intel-aero/Documents/doc_photos/pixhawk_aero_pinout.png

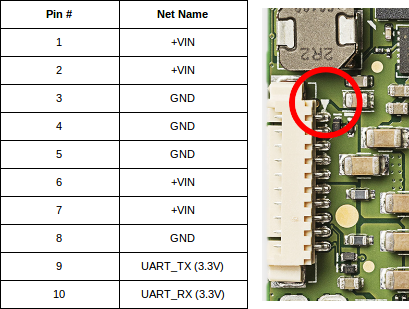
doc_photos/pixhawk_aero_pinout.png
