intel-aero/Documents/doc_photos/install_01_md5sum_linux.png

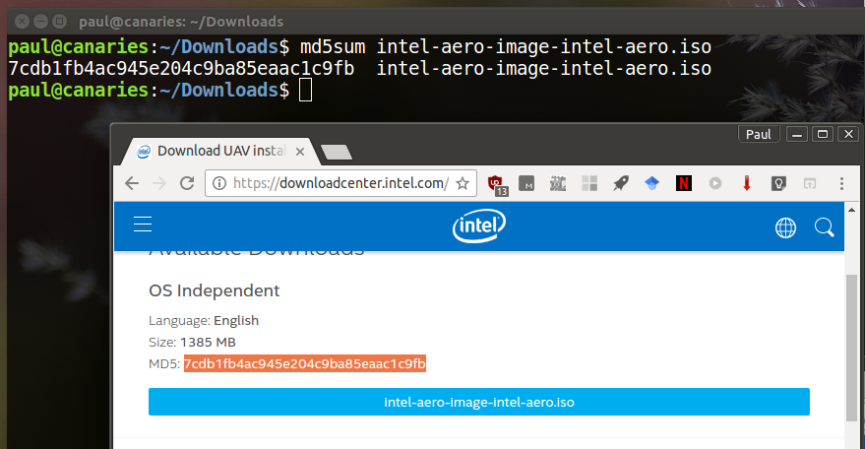
doc_photos/install_01_md5sum_linux.png
