intel-aero/Documents/README.md

# DISCONTINUATION OF PROJECT #
This project will no longer be maintained by Intel.
Intel has ceased development and contributions including, but not limited to, maintenance, bug fixes, new releases, or updates, to this project.
Intel no longer accepts patches to this project.
# Documents
Repo to upload Reference Documents and Mechanical CADs
