intel-aero/Documents/course/Readme.md

# Autonomous Drone Engineer Course

Do you know how power lines are checked? They send a customized helicopter with a highly trained crew to take photos. It’s slow, expensive and dangerous. The next step is of course to use a remotely controlled drone to take the pictures. It’s still slow and not scalable to the full size of the power line network.

That’s why we need autonomous drones, able to fly but also avoid collisions and analyze the situation as they go. Autonomous Drone Engineers will need to master a wide range of skills, from computer vision basics, embedded development and drone hardware design.

## Requirements
Linux programming in Python or C/C++. Basic Linux sysadmin.

[Intel Aero Ready-To-Fly Drone](http://intel.com/aero)

## Competences

After this training, the student will be able to:
•	analyze drone usage models, business models and market - relevant for all persons involved in drone projects
•	understand autonomous drone hardware and software architecture - relevant for drone developers and project managers
•	basic safe flight, drone maintenance skills, work with regulation - relevant for drone operator and drone developers
•	develop autonomous drones software for simple use cases - ex: following and adapting a mission outdoor
•	develop autonomous drones software for advanced use cases - ex: flying indoor or flights with strong flight-payload interactions

## Links:

* In parallel to the slides/videos, you should use the [Intel Aero's main wiki page](https://github.com/intel-aero/meta-intel-aero/wiki). Tip: It's easier to copy/paste code from the wiki than the slides.

* [Youtube Playlist](https://www.youtube.com/playlist?list=PLTQSXsG86pGfyZm5ac6-ZtQsEniUJIE9o)

* [Slides corresponding to the videos, in PPTX format](pptx)

* [Slides corresponding to the videos, in PDF format](pdf)

## Table of contents, with modules released and planned:
__A. Introduction__
* Intel Aero in 5mn.
* Autonomous Drone Usage Models.
* _Drones in society (soon)_

__B. Architecture__
* Introduction.
* Hardware architecture.
* 3D and visual sensors.
* Software Architecture.

__C.Lab setup__
* Flashing and lab setup.

__D. Drone software development__
* Hello world flight controller.
* Hello world networked drone.
* Docker containers.
* _ROS (very soon)_
* _Access cameras and stream (very soon)_

__E. Advanced drone software development__
* _Collision avoidance (soon)_
* _VISP (soon)_
* _SLAM (soon)_
* _Movidius Computer Vision (soon)_
* _Big Data in Real Time (soon)_
* _Gazebo simulator (soon)_

__F. Server side software development__
* _Cloud Sync (soon)_
* _SAP integration (soon)_
* _Mapping and GeoData (soon)_
* _3D reconstruction (soon)_
* _Big Data (soon)_

__G.	Productizing__
* _VPNs (very soon)_
* _LTE Modem (soon)_
* _3D printing accessories (very soon)_

__H.	Entrepreneurship__
* _Ecosystem (soon)_
* _Ideation (soon)_
* _Promotion (soon)_
