intel-aero/Documents/doc_photos/aero_gazebo.png

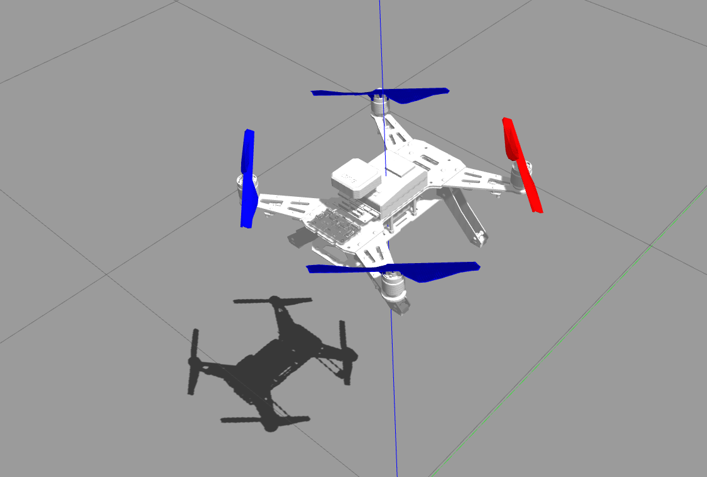
doc_photos/aero_gazebo.png
