intel-aero/Documents/doc_photos/cables_jack.jpg

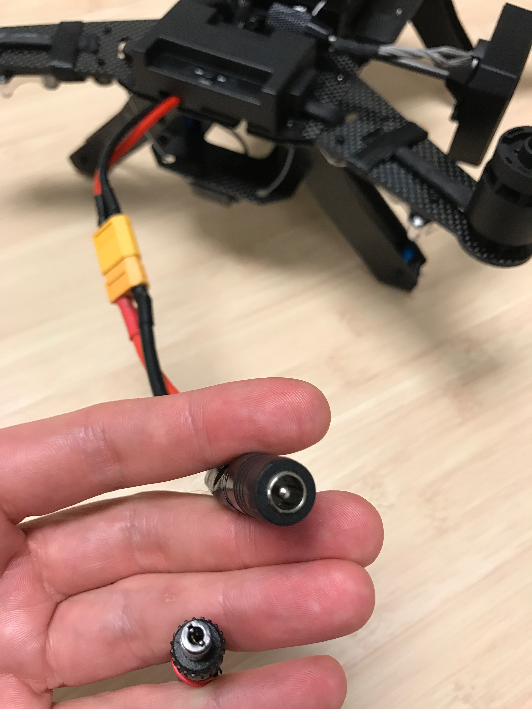
doc_photos/cables_jack.jpg
