intel-aero/Documents/doc_photos/cables_microHDMI.jpg

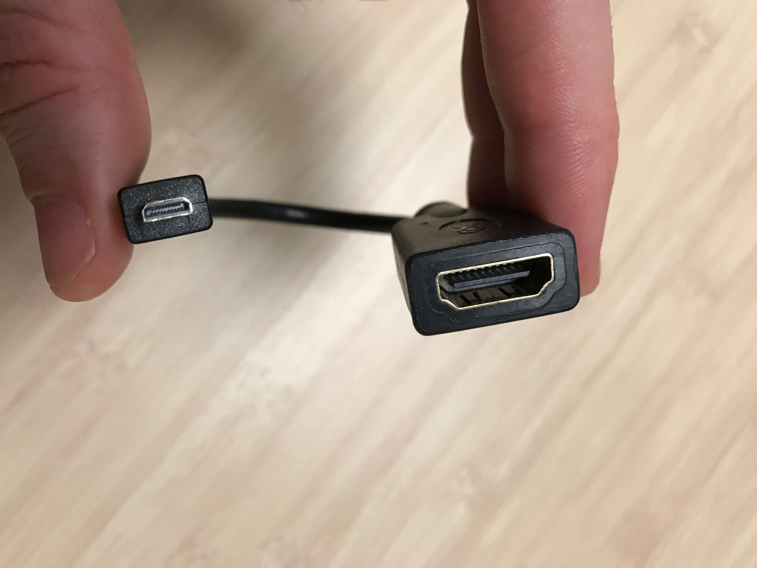
doc_photos/cables_microHDMI.jpg
