intel-aero/Documents/doc_photos/cables_OTG-USB2.jpg

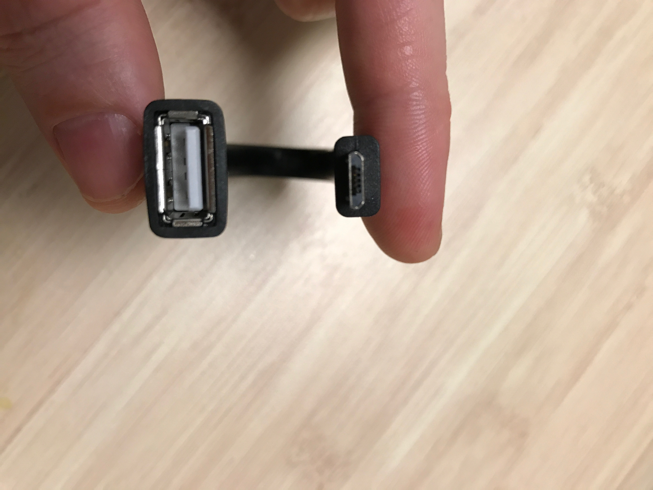
doc_photos/cables_OTG-USB2.jpg
