intel-aero/Documents/doc_photos/cables_usb-hdmi-connected.jpg

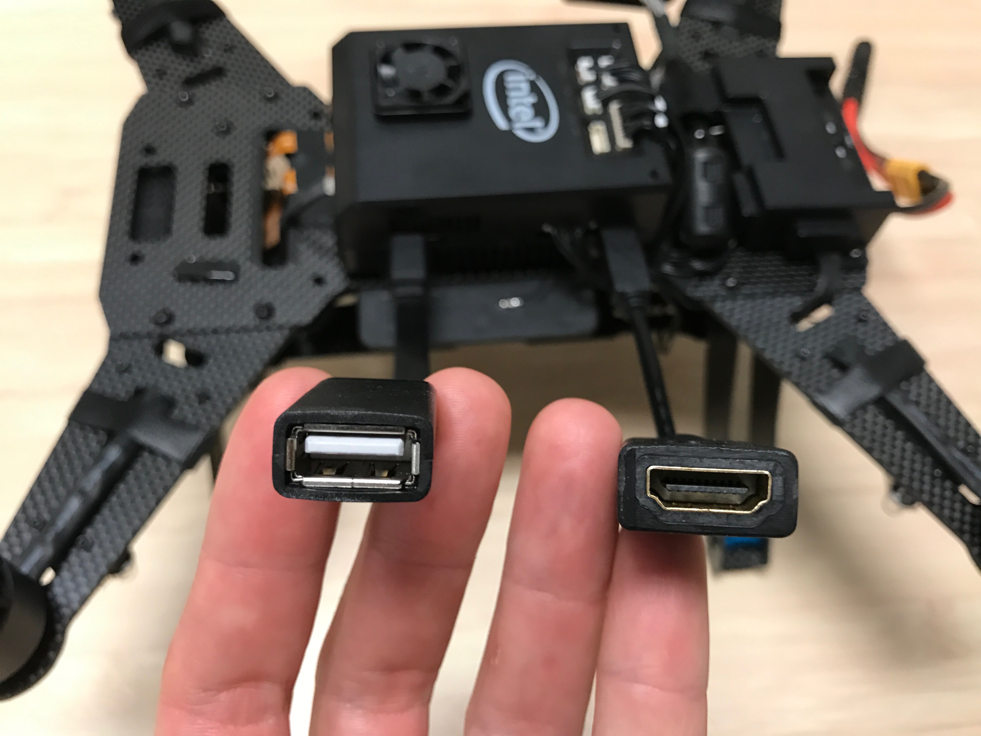
doc_photos/cables_usb-hdmi-connected.jpg
