intel-aero/Documents/doc_photos/cables_XT60.jpg

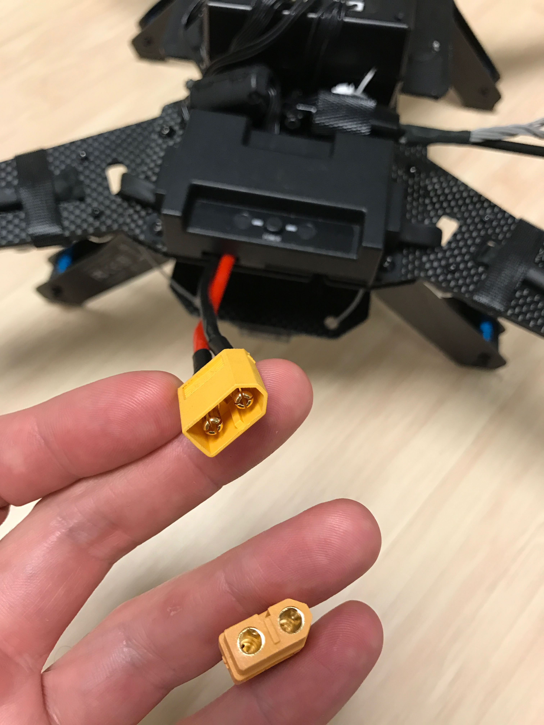
doc_photos/cables_XT60.jpg
