intel-aero/Documents/doc_photos/camera_bottom.png

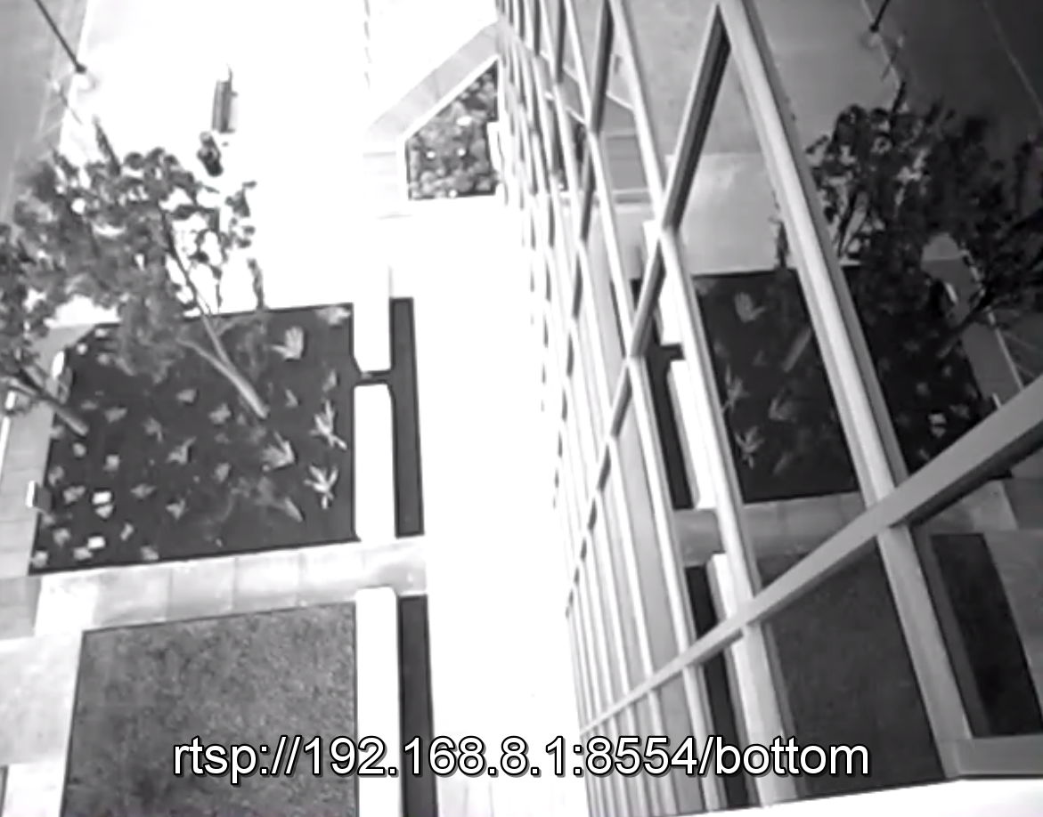
doc_photos/camera_bottom.png
