intel-aero/Documents/doc_photos/ecosystem-skysense.jpg

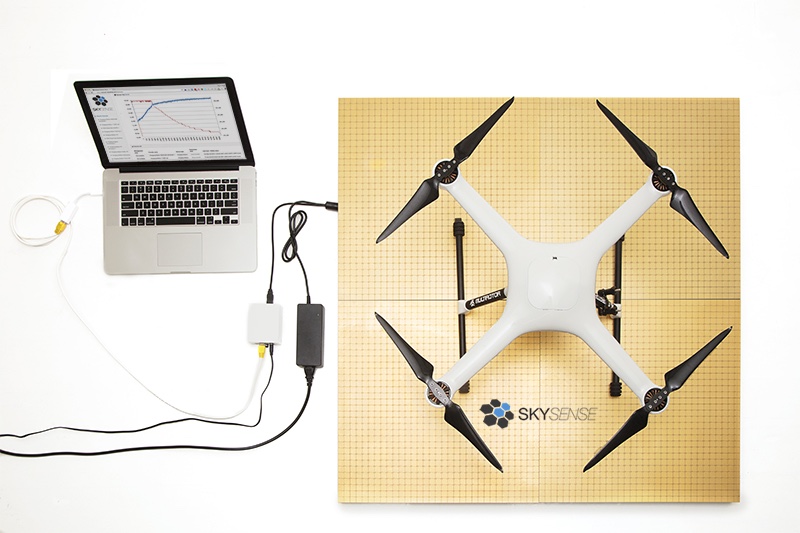
doc_photos/ecosystem-skysense.jpg
