intel-aero/Documents/doc_photos/fcm.png

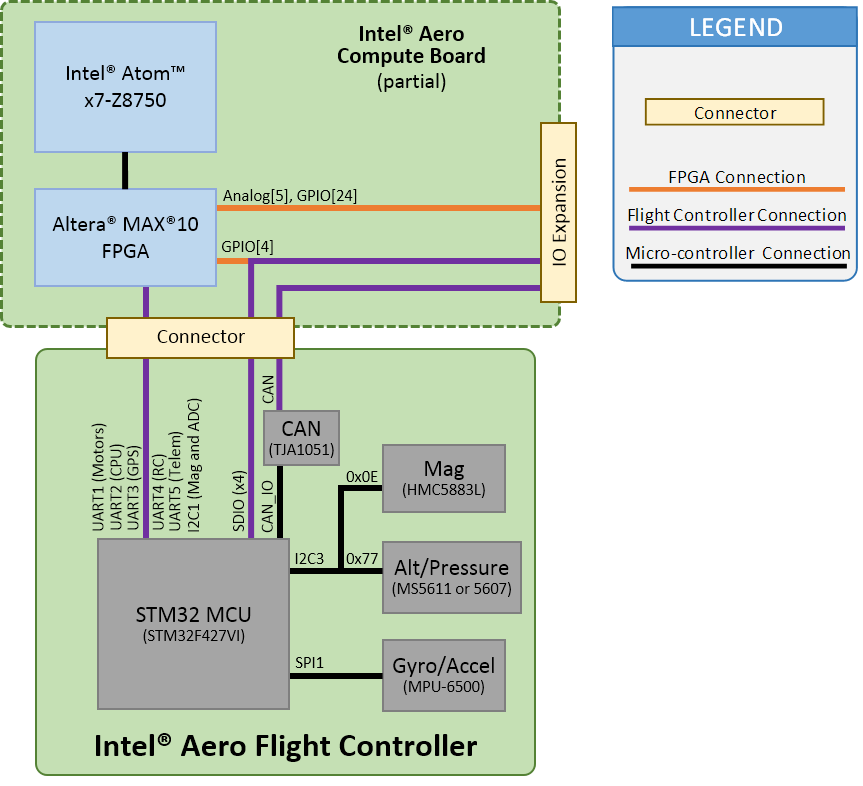
doc_photos/fcm.png
