intel-aero/Documents/doc_photos/guvcview.png

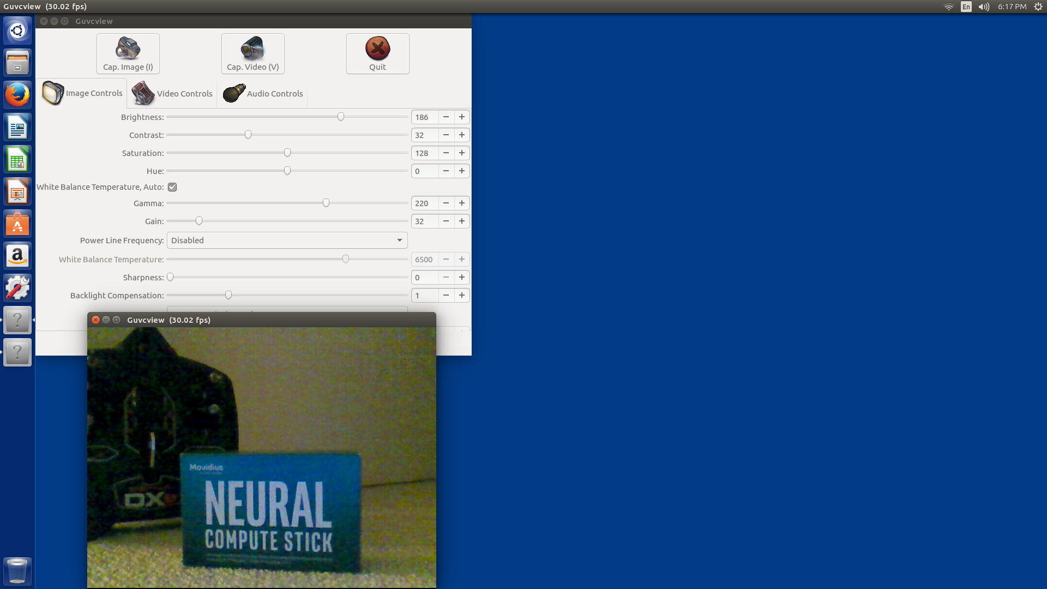
doc_photos/guvcview.png
