intel-aero/Documents/doc_photos/lte_enclosure.png

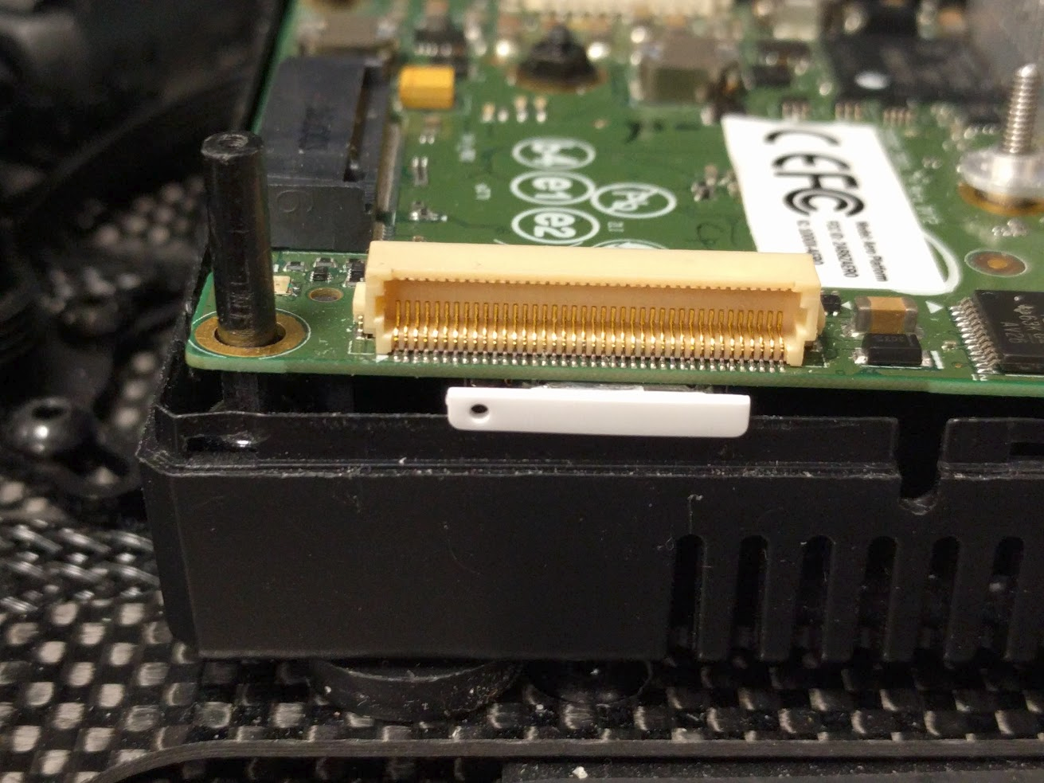
doc_photos/lte_enclosure.png
