intel-aero/Documents/doc_photos/lte_enclosure_modified.png

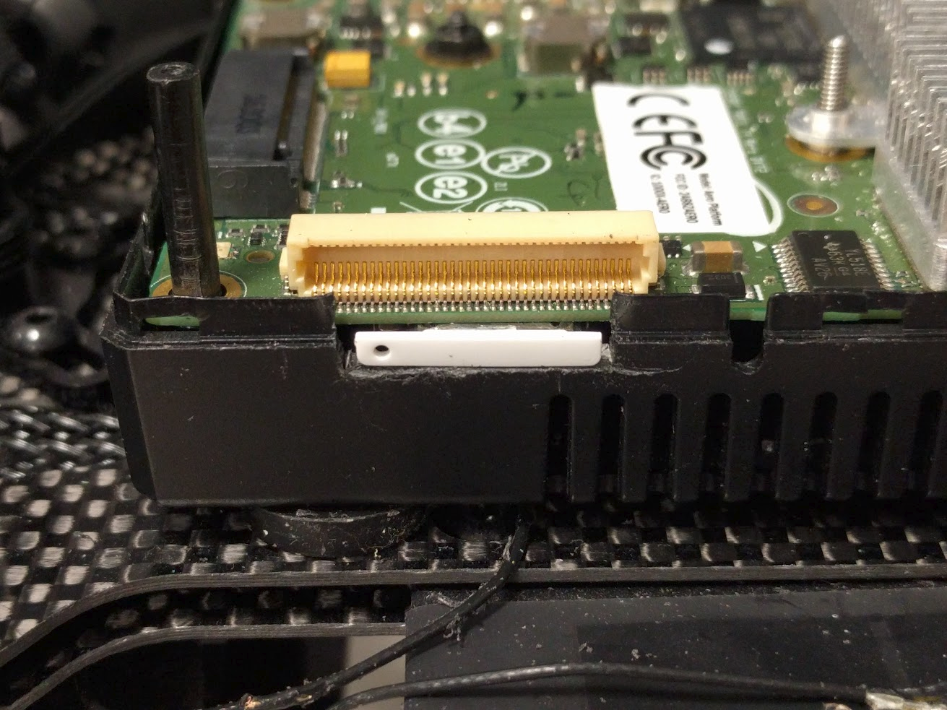
doc_photos/lte_enclosure_modified.png
