intel-aero/Documents/doc_photos/lte_modem_antenna.png

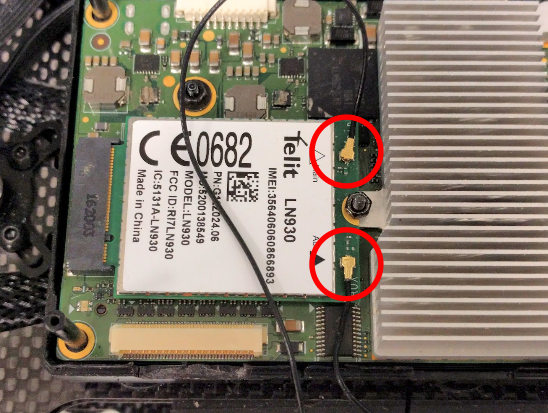
doc_photos/lte_modem_antenna.png
