intel-aero/Documents/doc_photos/lte_modem_fit.png

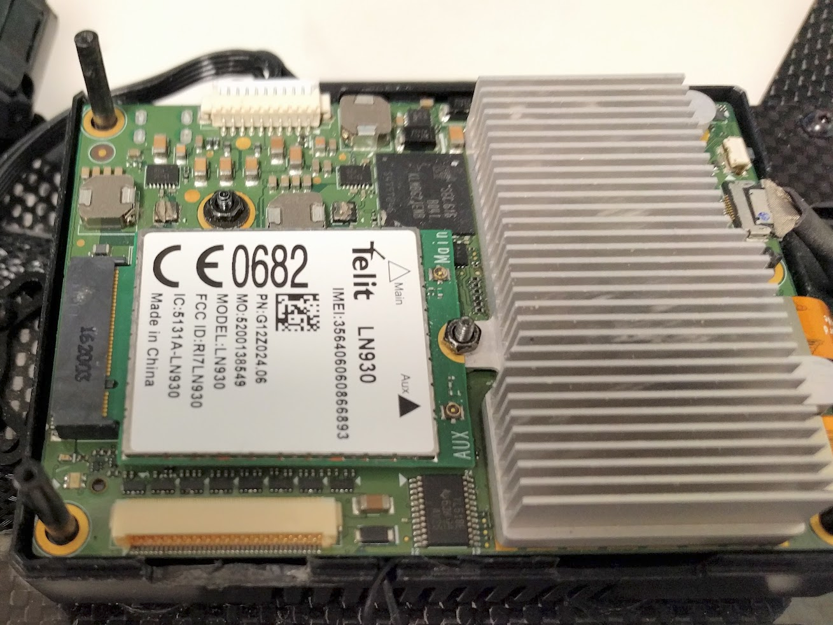
doc_photos/lte_modem_fit.png
