intel-aero/Documents/doc_photos/lte_modem_tilt.png

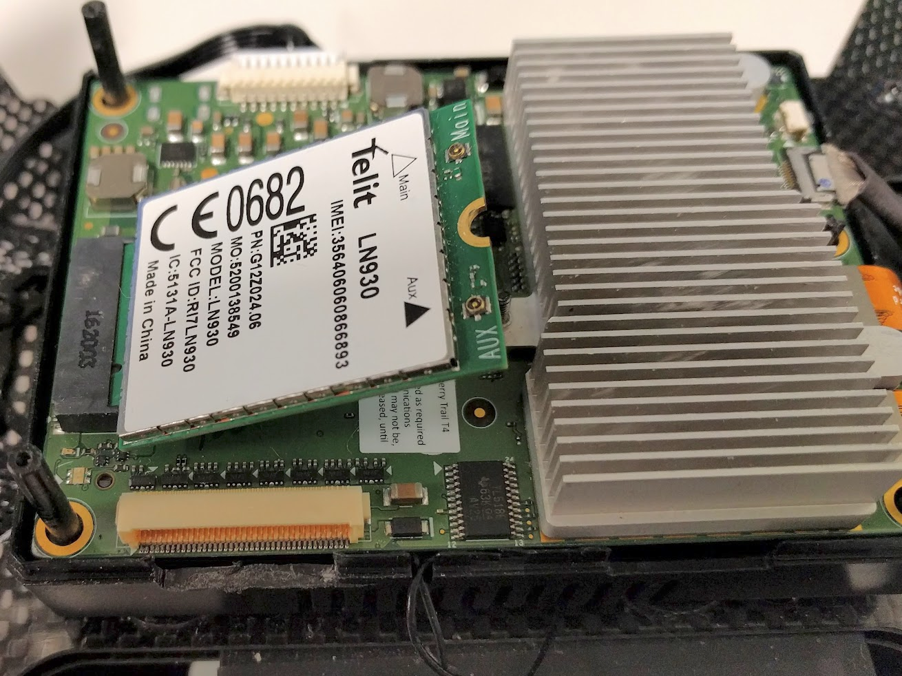
doc_photos/lte_modem_tilt.png
