intel-aero/Documents/doc_photos/lte_wifi_antenna.png

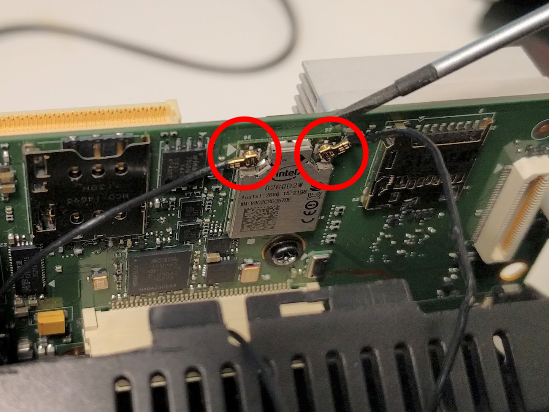
doc_photos/lte_wifi_antenna.png
