intel-aero/Documents/doc_photos/movidius_pekinese.png

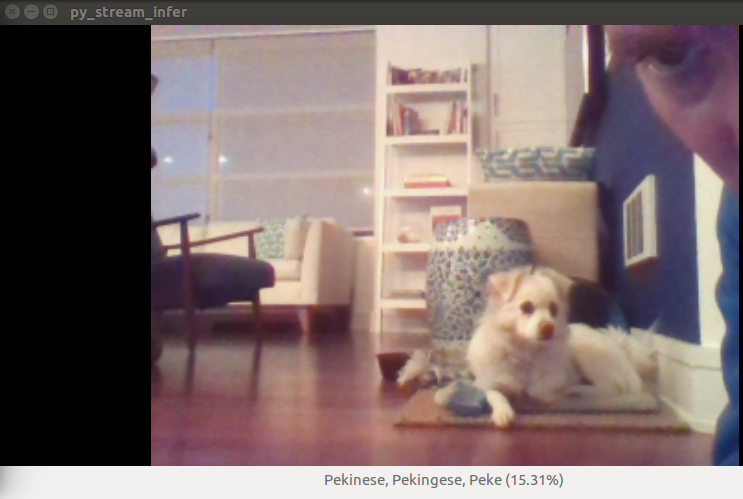
doc_photos/movidius_pekinese.png
