intel-aero/Documents/doc_photos/pixhawk_aero.png

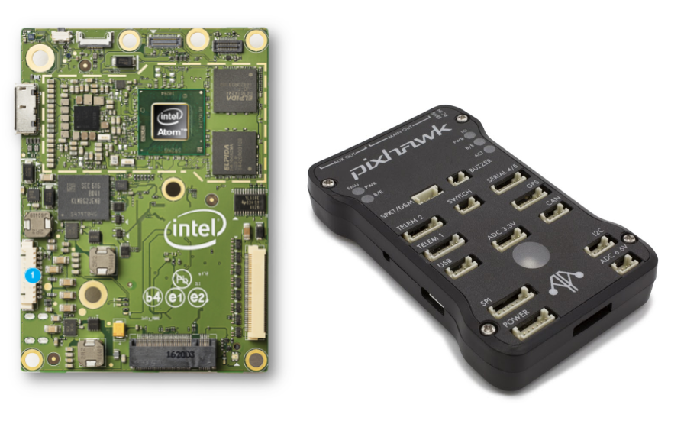
doc_photos/pixhawk_aero.png
