intel-aero/Documents/doc_photos/pixhawk_aero_ports.png

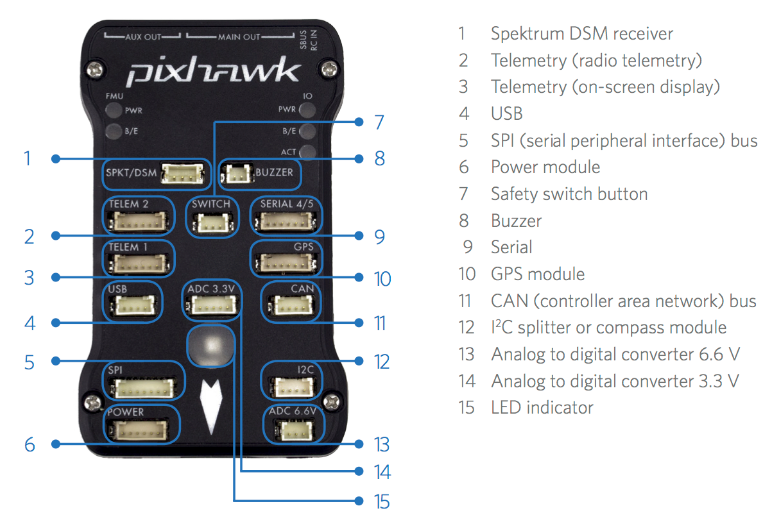
doc_photos/pixhawk_aero_ports.png
