intel-aero/Documents/doc_photos/pixhawk_aero_power_cable.jpg

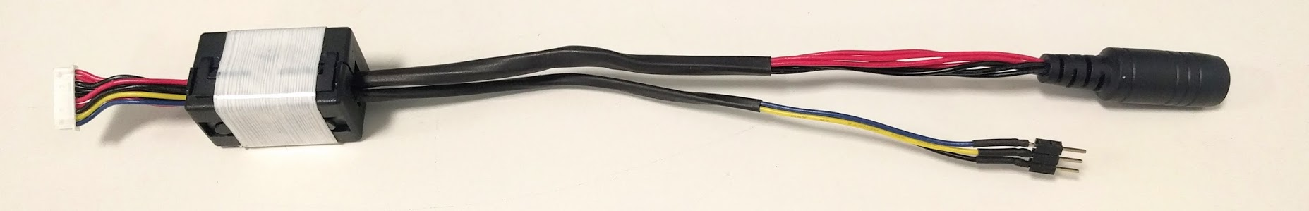
doc_photos/pixhawk_aero_power_cable.jpg
