intel-aero/Documents/doc_photos/pixhawk_aero_uart_cable.png

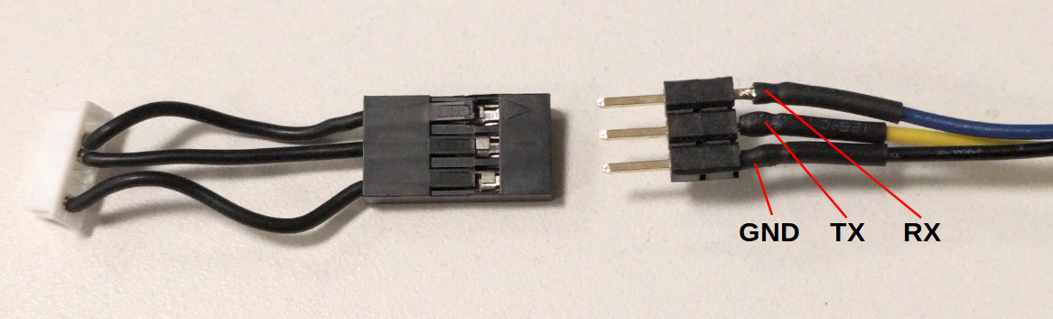
doc_photos/pixhawk_aero_uart_cable.png
