intel-aero/Documents/doc_photos/pixhawk_pinout.png

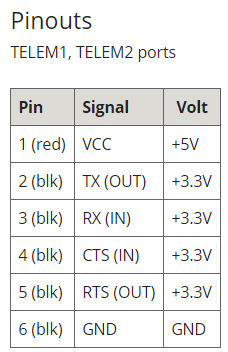
doc_photos/pixhawk_pinout.png
