intel-aero/Documents/doc_photos/playlist.png

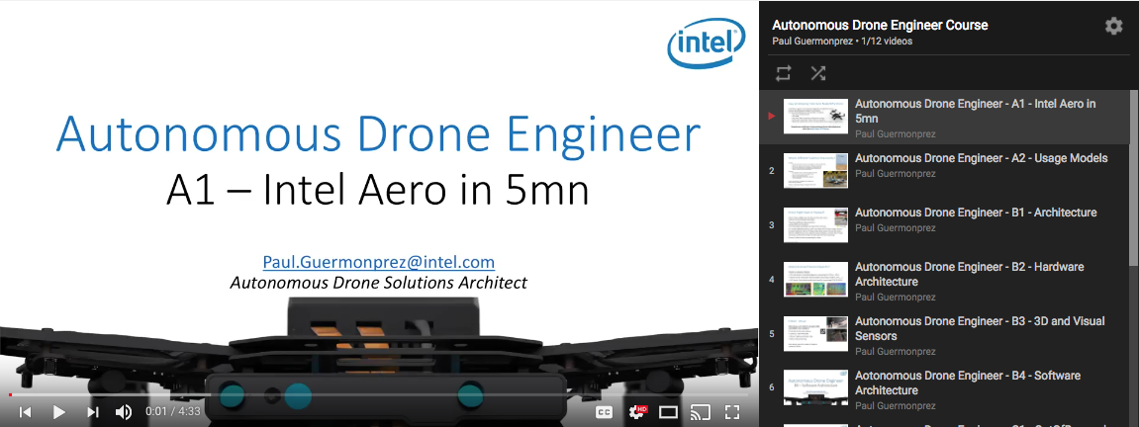
doc_photos/playlist.png
