intel-aero/Documents/doc_photos/python_eric.png

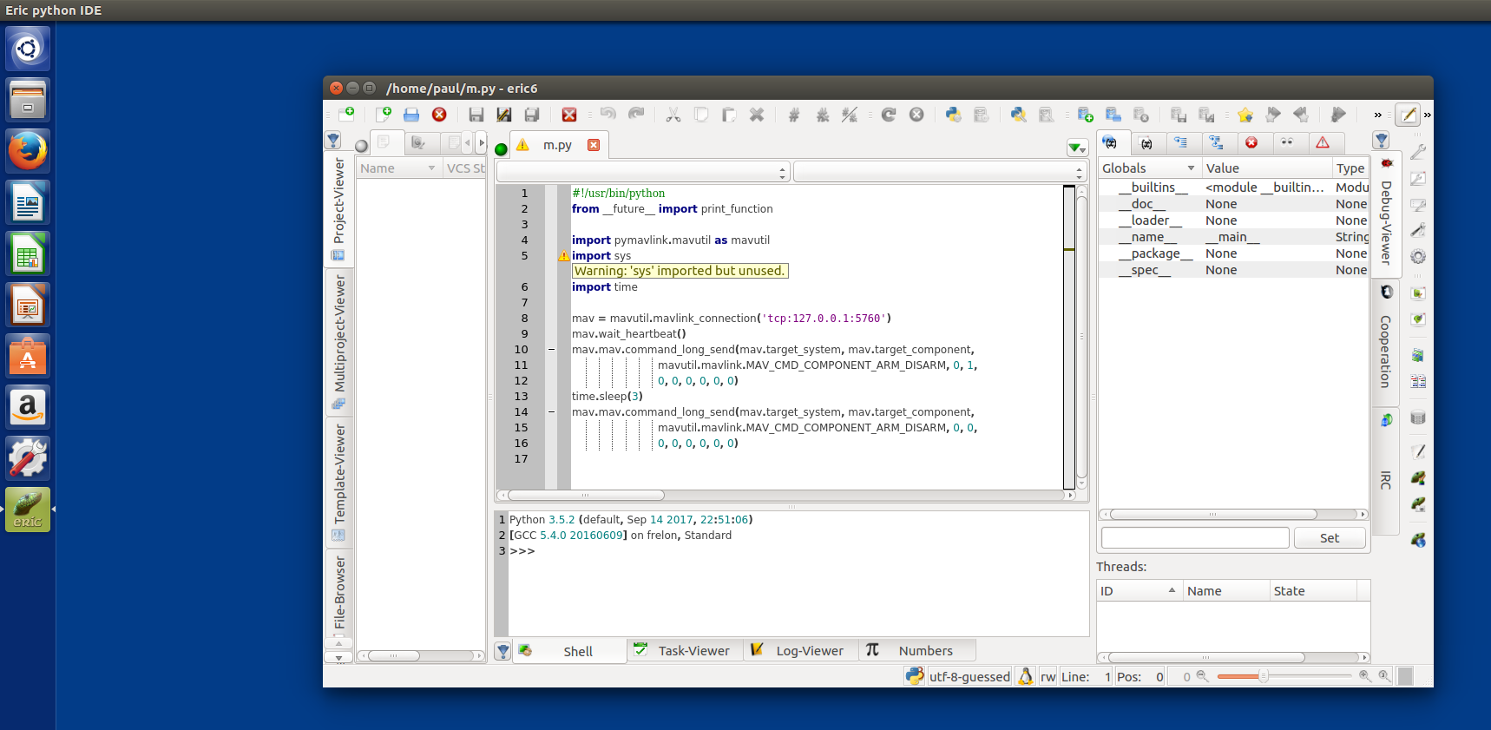
doc_photos/python_eric.png
