intel-aero/Documents/doc_photos/python_idle.png

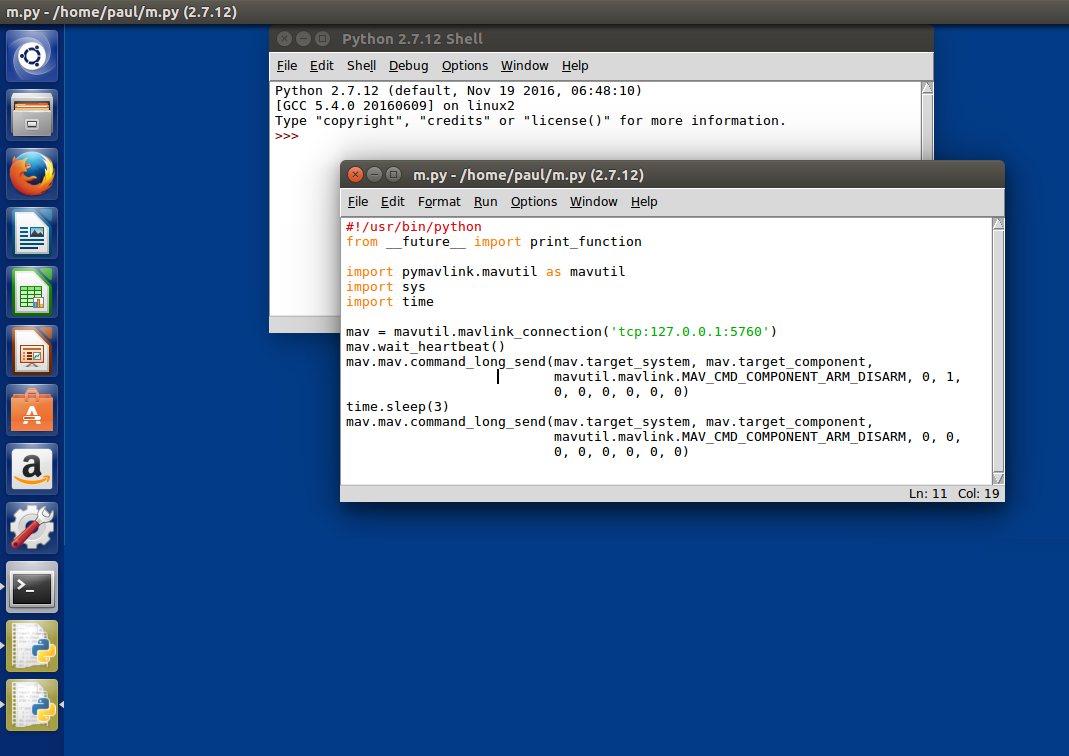
doc_photos/python_idle.png
