intel-aero/Documents/doc_photos/python_vim.png

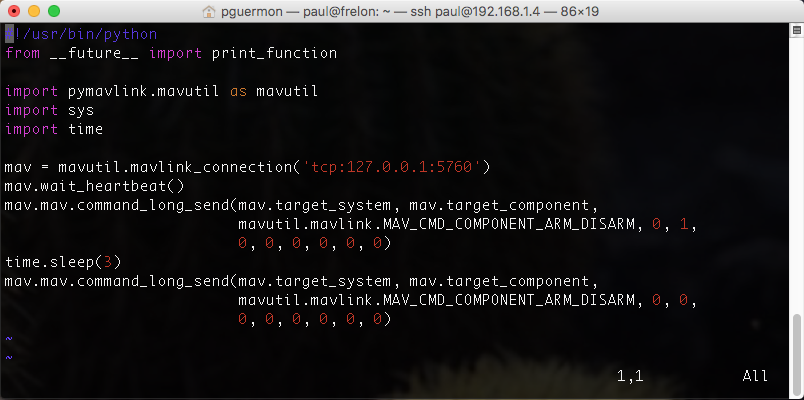
doc_photos/python_vim.png
