intel-aero/Documents/doc_photos/qgc_connected.png

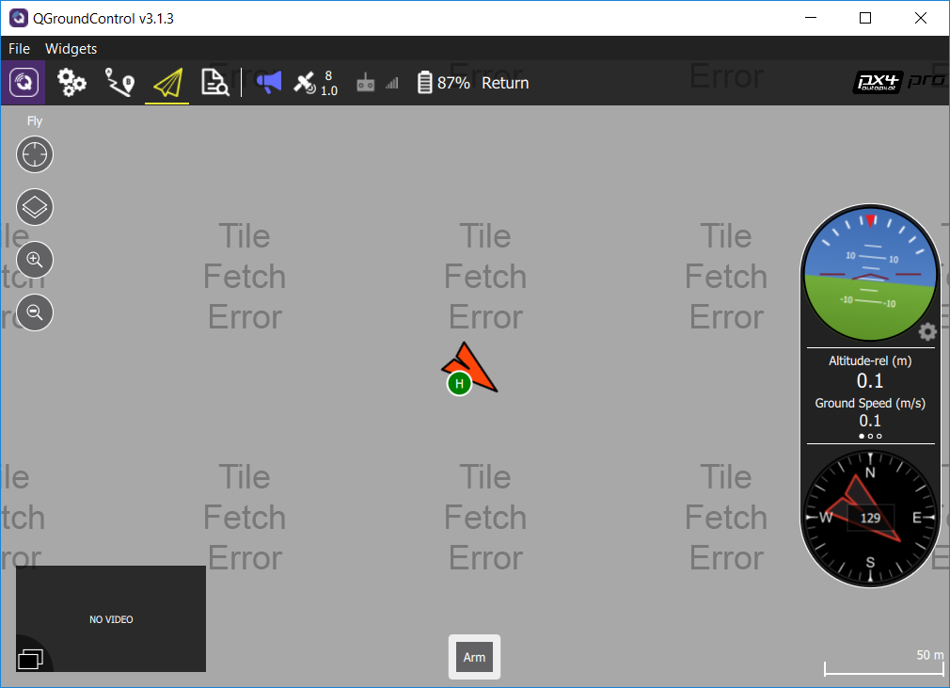
doc_photos/qgc_connected.png
