intel-aero/Documents/doc_photos/qgc_notconnected.png

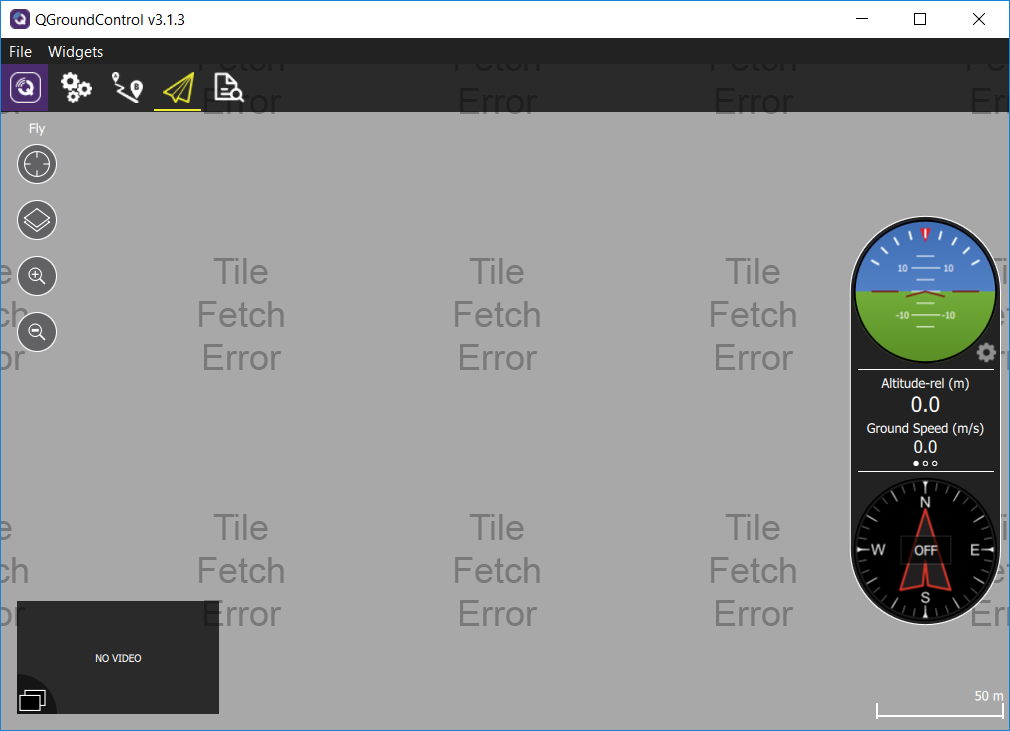
doc_photos/qgc_notconnected.png
