intel-aero/Documents/doc_photos/qgc_rtsp.png

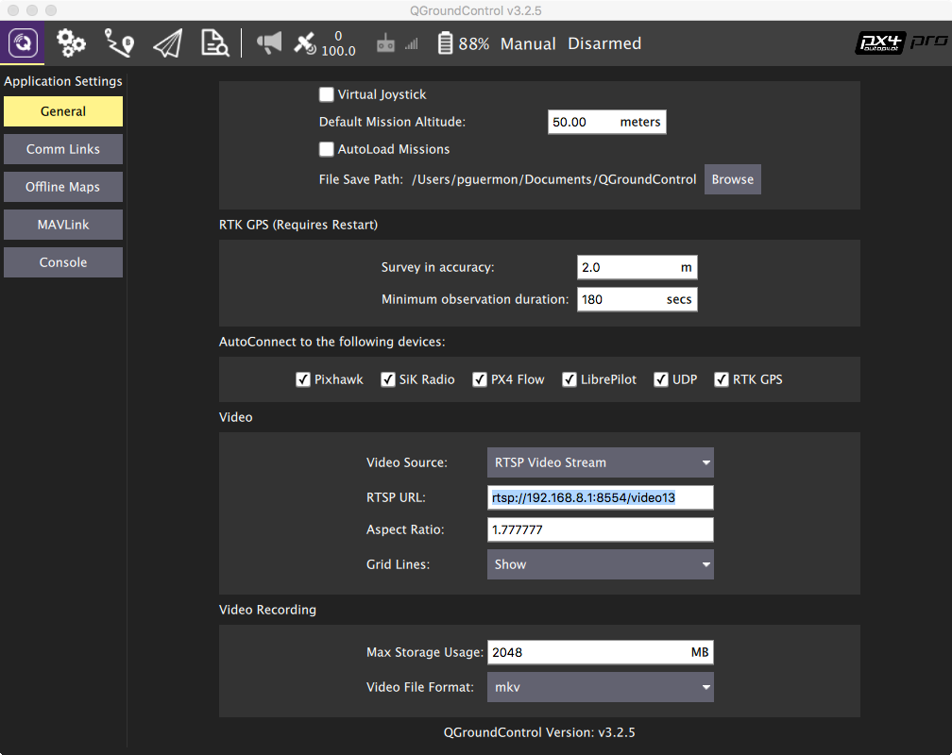
doc_photos/qgc_rtsp.png
