intel-aero/Documents/doc_photos/qgc_rtsp_video.png

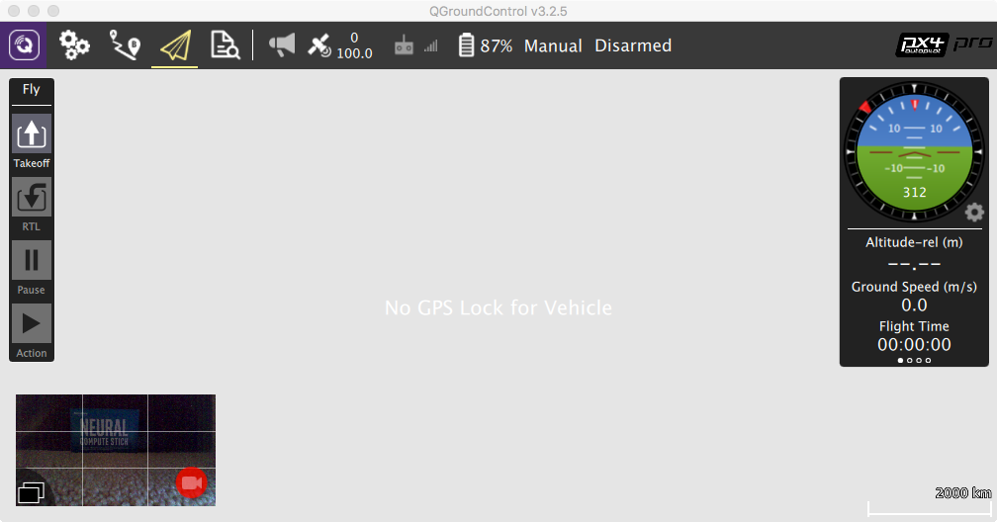
doc_photos/qgc_rtsp_video.png
