intel-aero/Documents/doc_photos/rgb-led-rtf.png

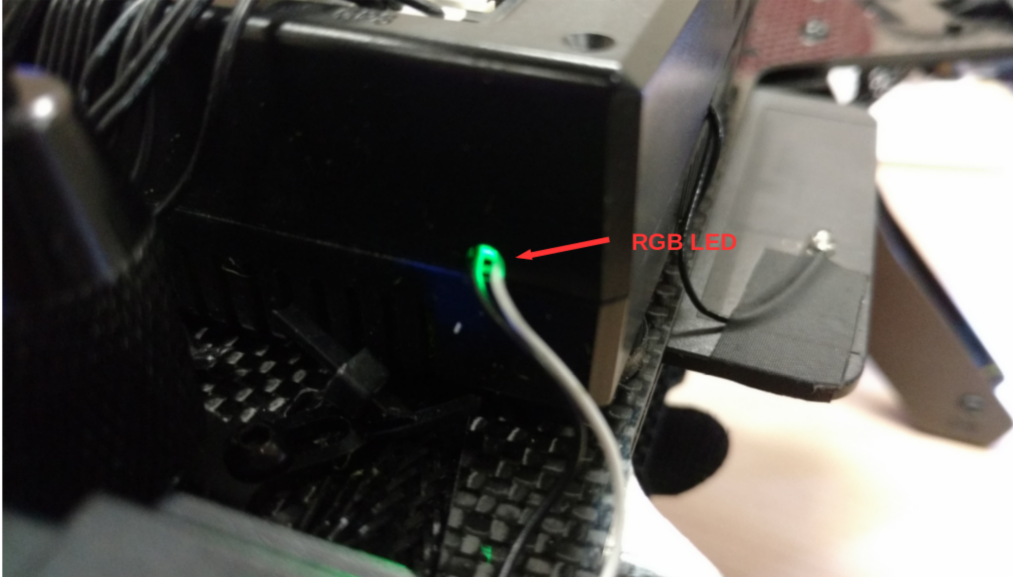
doc_photos/rgb-led-rtf.png
