intel-aero/Documents/doc_photos/ros_pointcloud.png

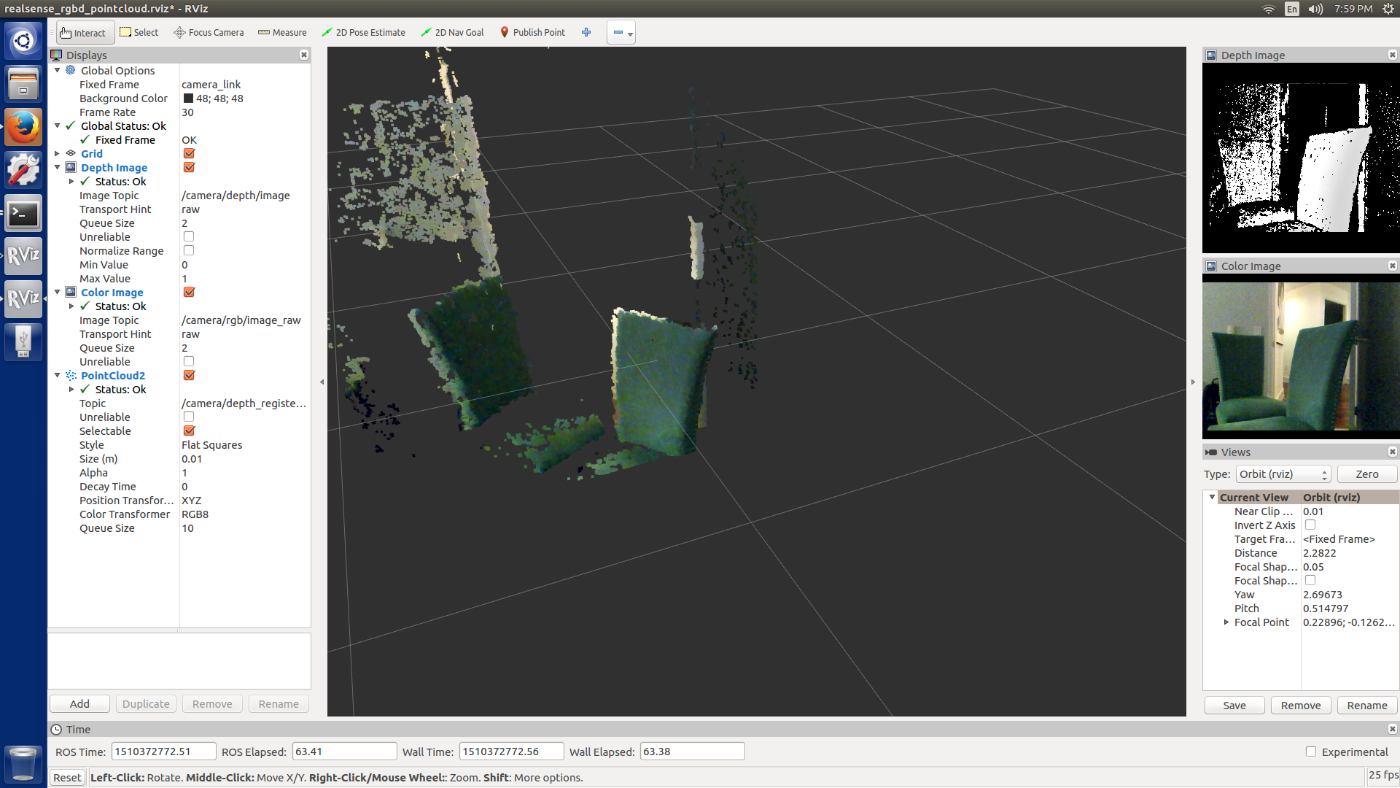
doc_photos/ros_pointcloud.png
