intel-aero/Documents/doc_photos/ros_slam.png

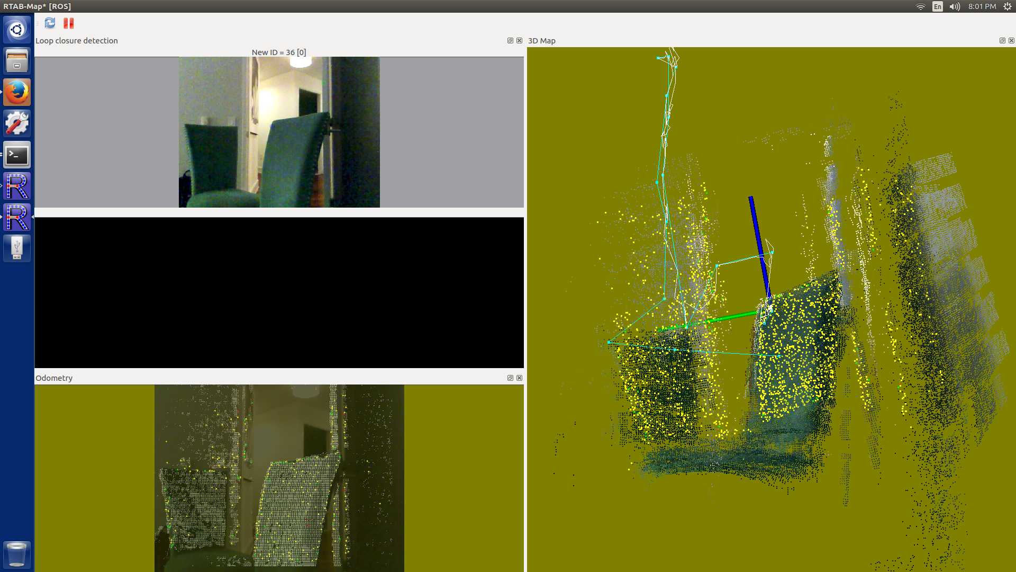
doc_photos/ros_slam.png
