intel-aero/Documents/doc_photos/ros_terms.png

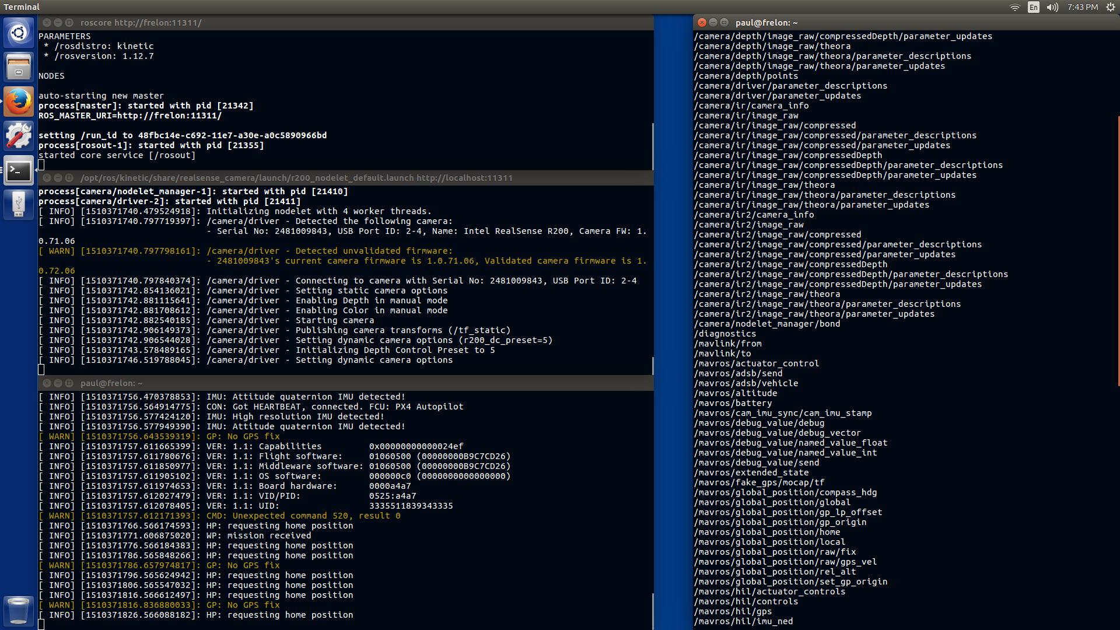
doc_photos/ros_terms.png
