intel-aero/Documents/doc_photos/rs_color_intel.png

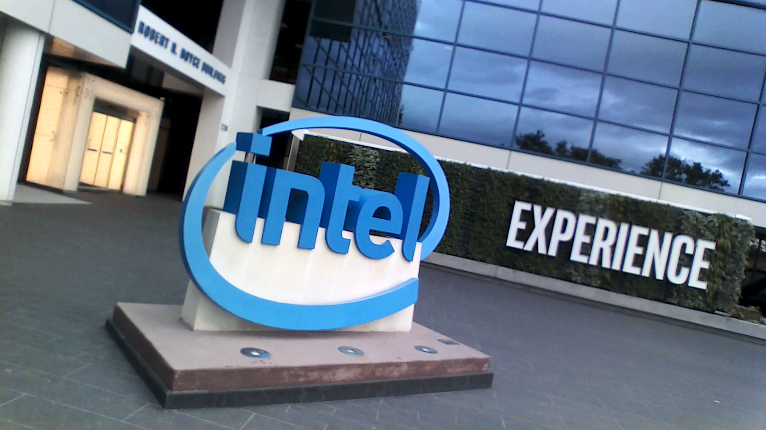
doc_photos/rs_color_intel.png
