intel-aero/Documents/doc_photos/rs_cpp-capture_chairs.png

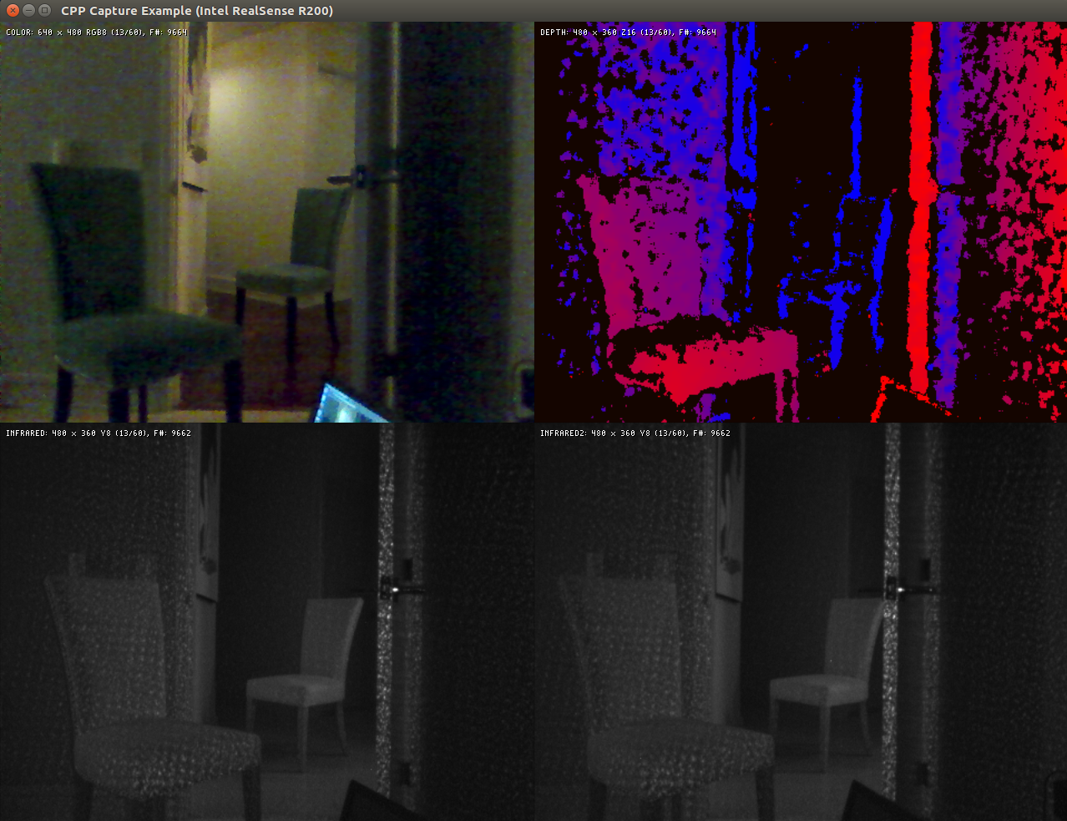
doc_photos/rs_cpp-capture_chairs.png
