intel-aero/Documents/doc_photos/rs_texture_dog.png

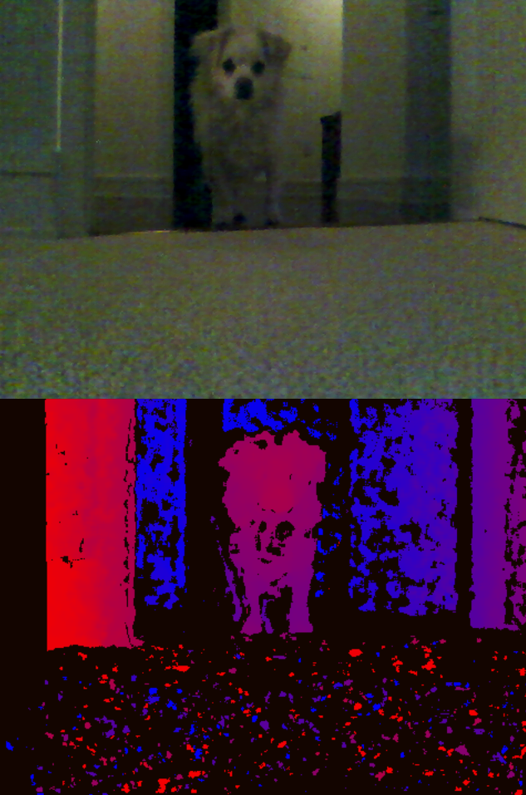
doc_photos/rs_texture_dog.png
