intel-aero/Documents/doc_photos/rs_works_in_the_dark.png

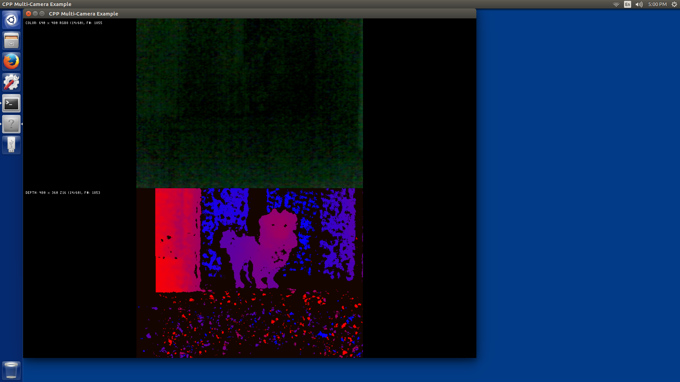
doc_photos/rs_works_in_the_dark.png
