intel-aero/Documents/doc_photos/sales_kit_1.jpg

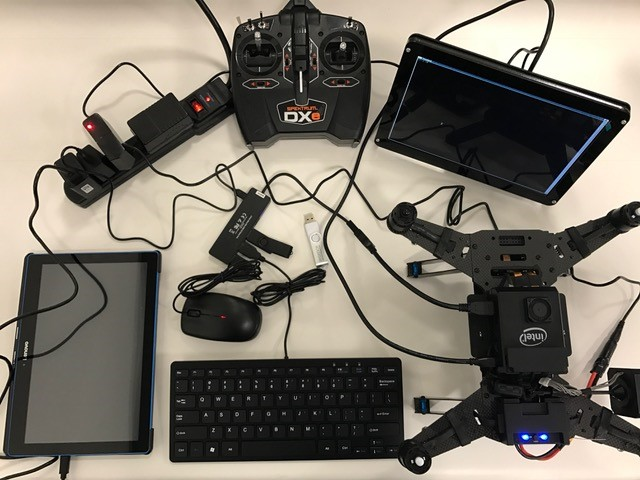
doc_photos/sales_kit_1.jpg
