intel-aero/Documents/doc_photos/sales_kit_2.jpg

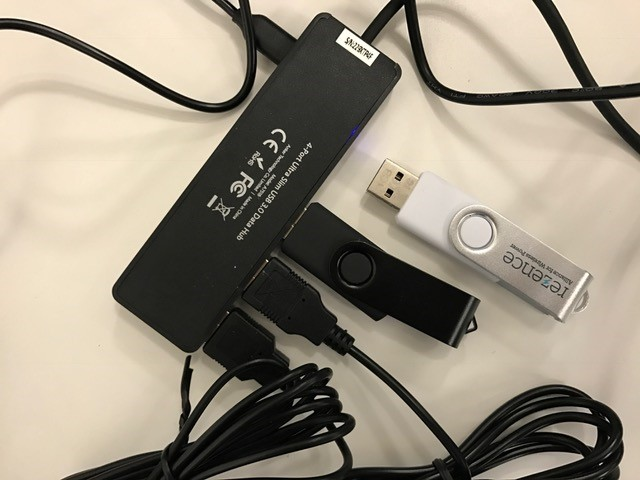
doc_photos/sales_kit_2.jpg
