intel-aero/Documents/doc_photos/sales_kit_3.jpg

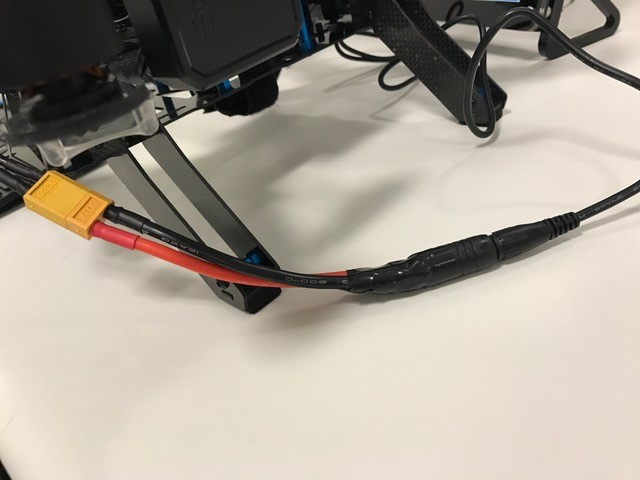
doc_photos/sales_kit_3.jpg
