intel-aero/Documents/doc_photos/sales_kit_4.jpg

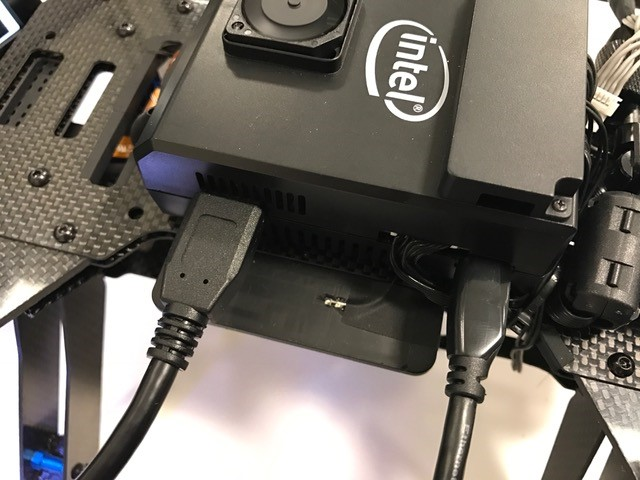
doc_photos/sales_kit_4.jpg
