intel-aero/Documents/doc_photos/unboxing_Intel_Aero_Compute_Board.jpg

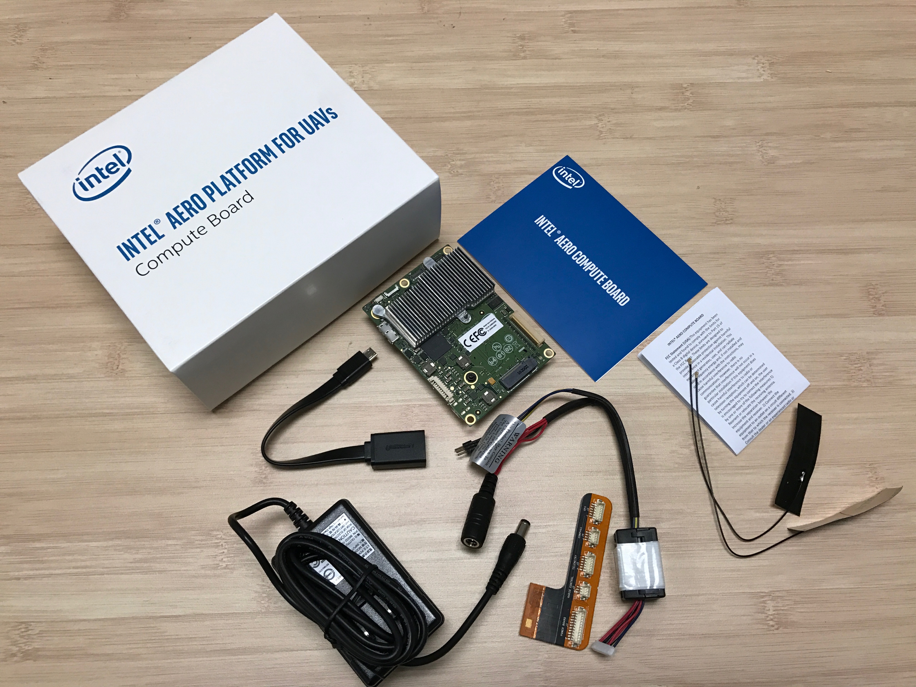
doc_photos/unboxing_Intel_Aero_Compute_Board.jpg
