intel-aero/Documents/doc_photos/unboxing_Intel_Aero_Computer_Vision_kit.jpg

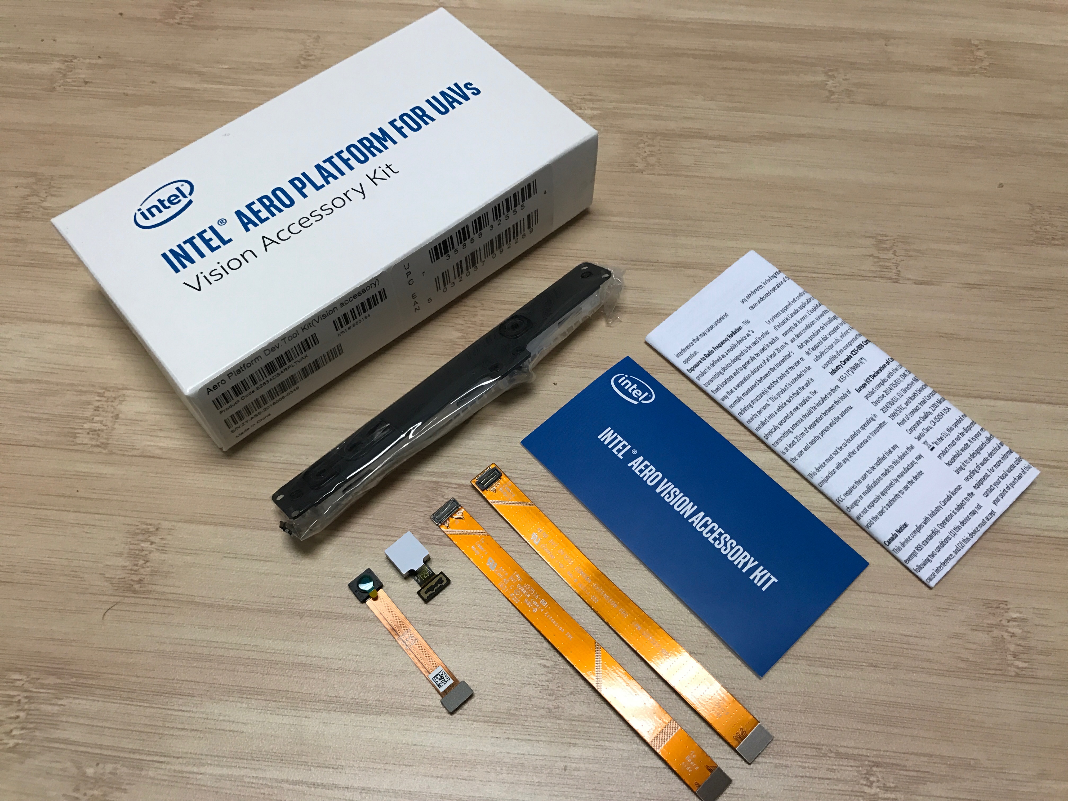
doc_photos/unboxing_Intel_Aero_Computer_Vision_kit.jpg
