intel-aero/Documents/doc_photos/unboxing_Intel_Aero_Enclosure_kit.jpg

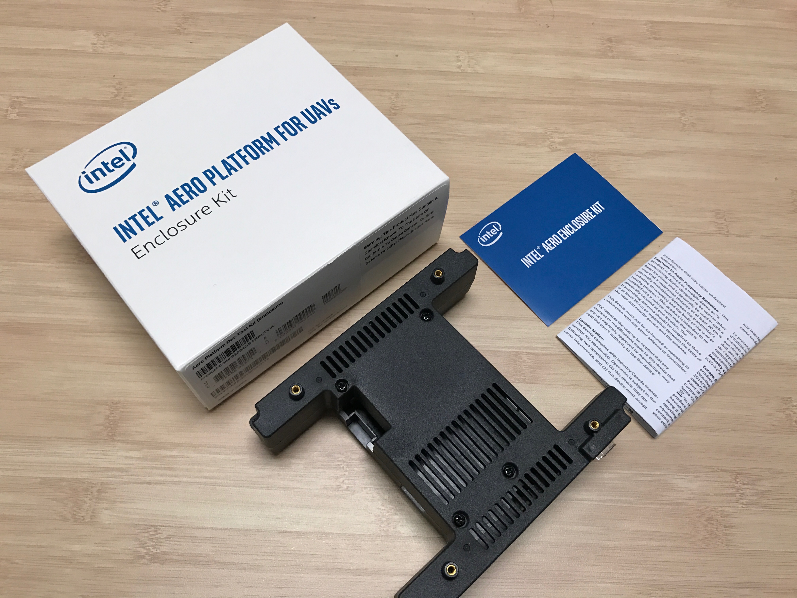
doc_photos/unboxing_Intel_Aero_Enclosure_kit.jpg
