intel-aero/Documents/doc_photos/unboxing_Intel_Aero_RTK_kit.jpg

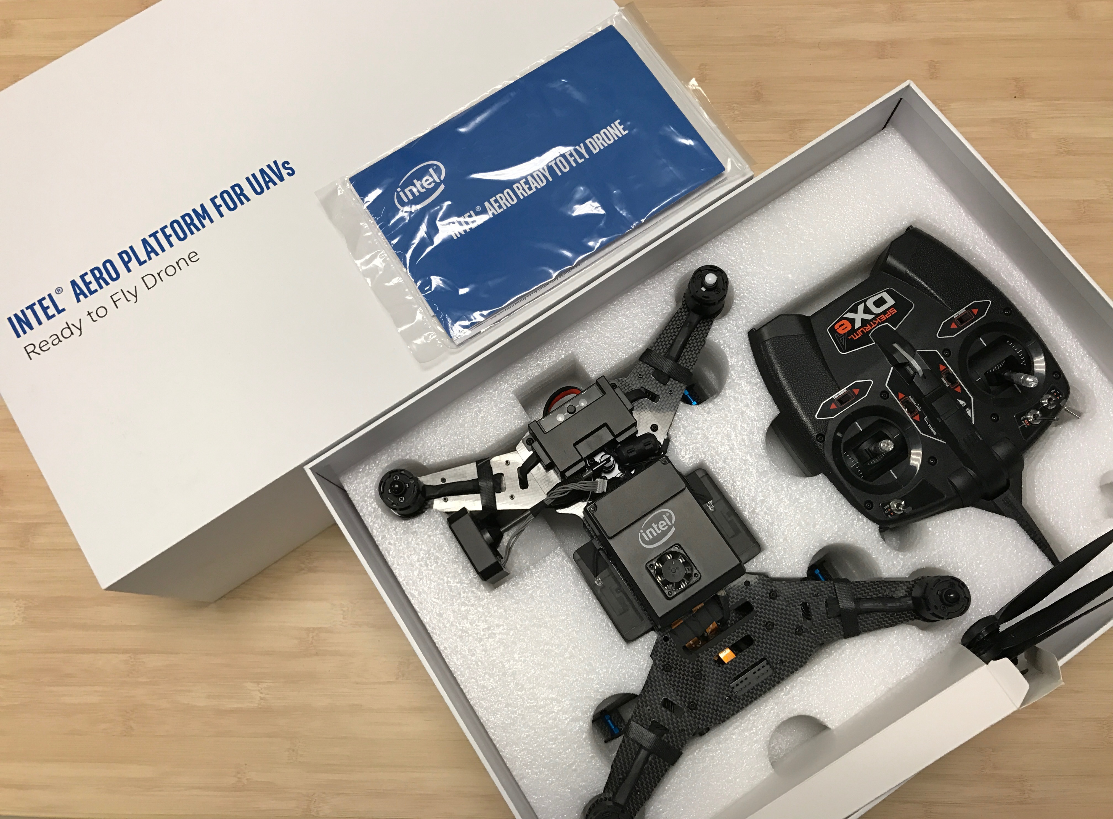
doc_photos/unboxing_Intel_Aero_RTK_kit.jpg
