intel-aero/Documents/doc_photos/vlc_rtsp.png

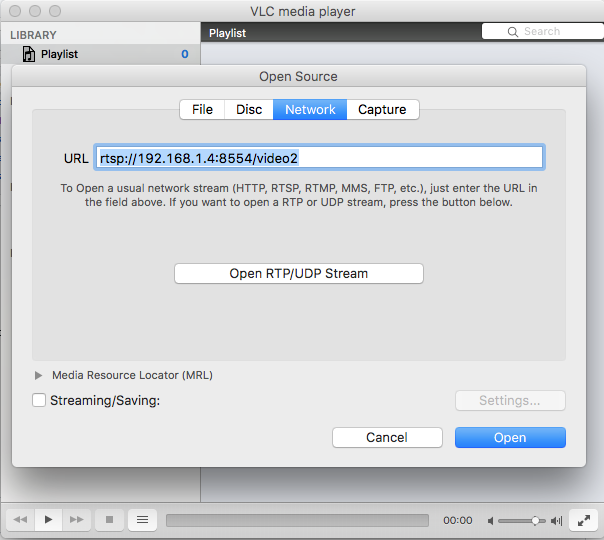
doc_photos/vlc_rtsp.png
