intel-aero/Documents/mechanical_cad/compute-board/compute-board-dimensions.png

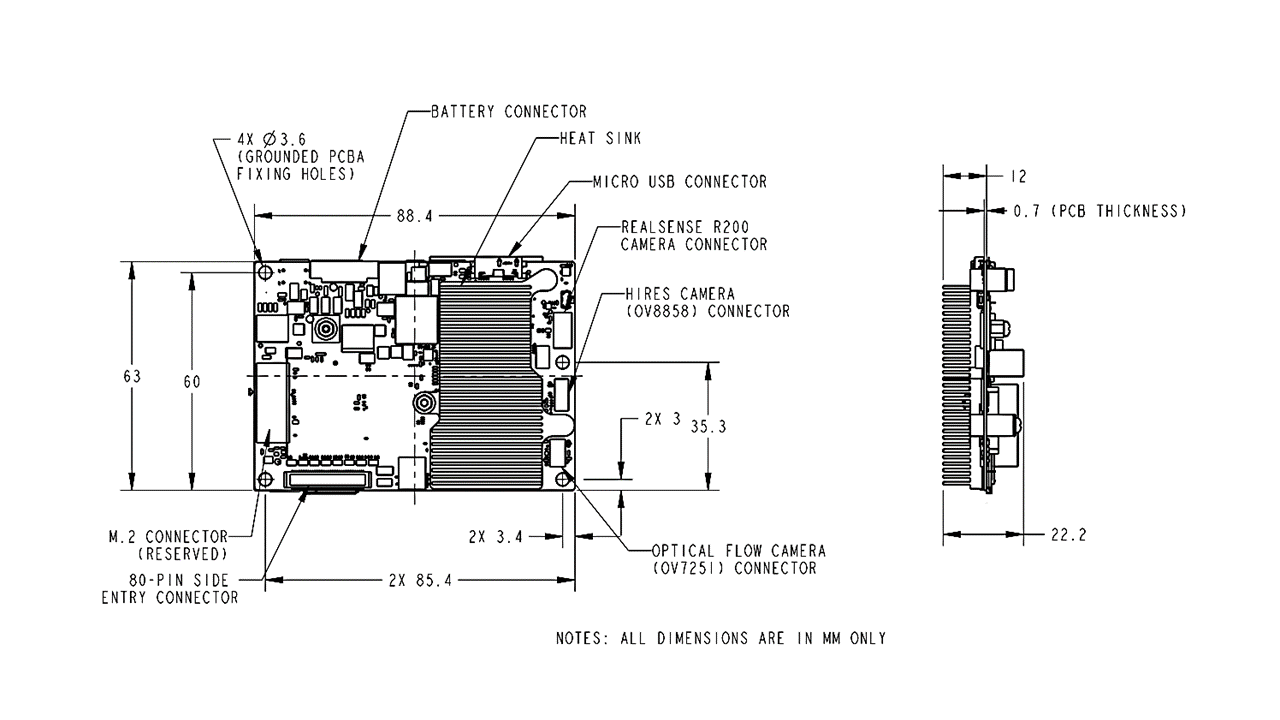
mechanical_cad/compute-board/compute-board-dimensions.png
