intel-aero/Documents/mechanical_cad/enclosure-kit/enclosure-kit-dimensions.png

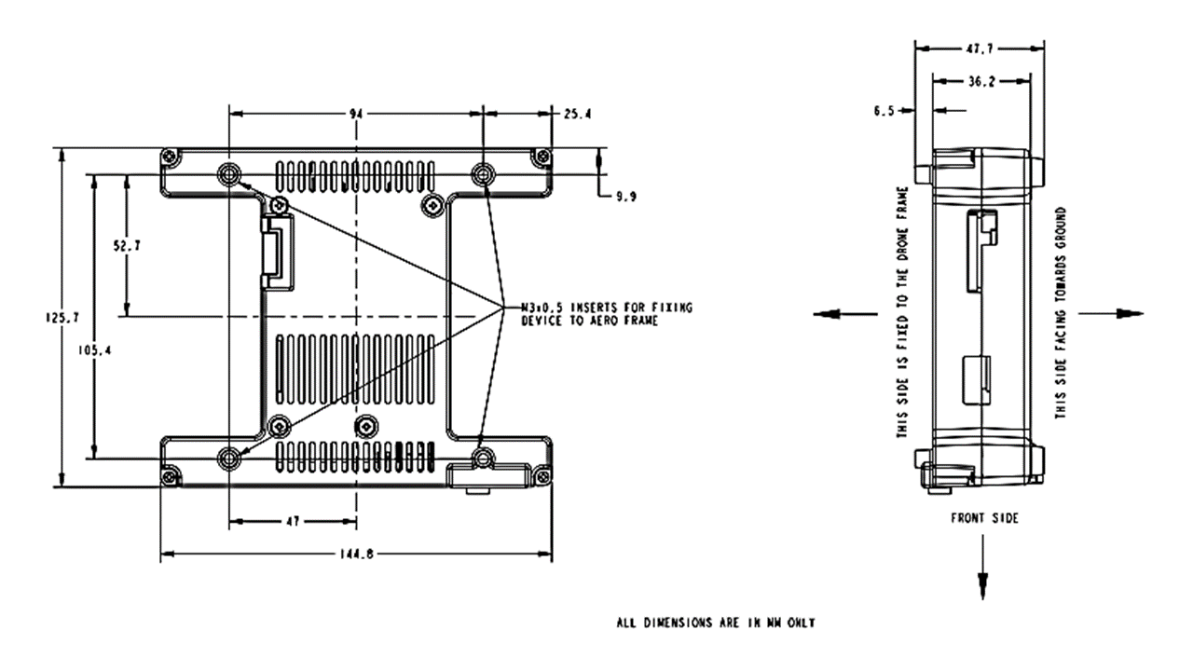
mechanical_cad/enclosure-kit/enclosure-kit-dimensions.png
