intel-aero/Documents/mechanical_cad/antenna-mount/antenna-mount.STL

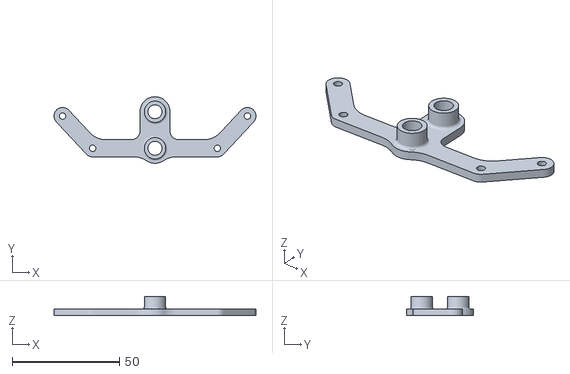
[picture p75: CAD file, 2017-07-03]
mechanical_cad/antenna-mount/antenna-mount.STL
94.0 x 31.0 x 9.00
