intel-aero/Documents/mechanical_cad/cgo3+-gimbal/cgo3+-gimbal-mount.STL

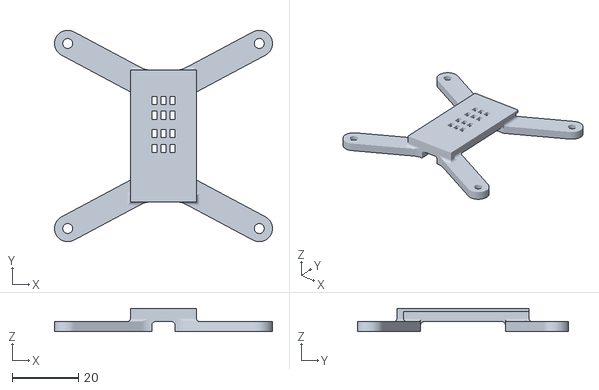
[picture p76: CAD file, 2017-06-29]
mechanical_cad/cgo3+-gimbal/cgo3+-gimbal-mount.STL
66.0 x 64.0 x 7.00
