intel-aero/Documents/mechanical_cad/compute-board/compute-board.stl

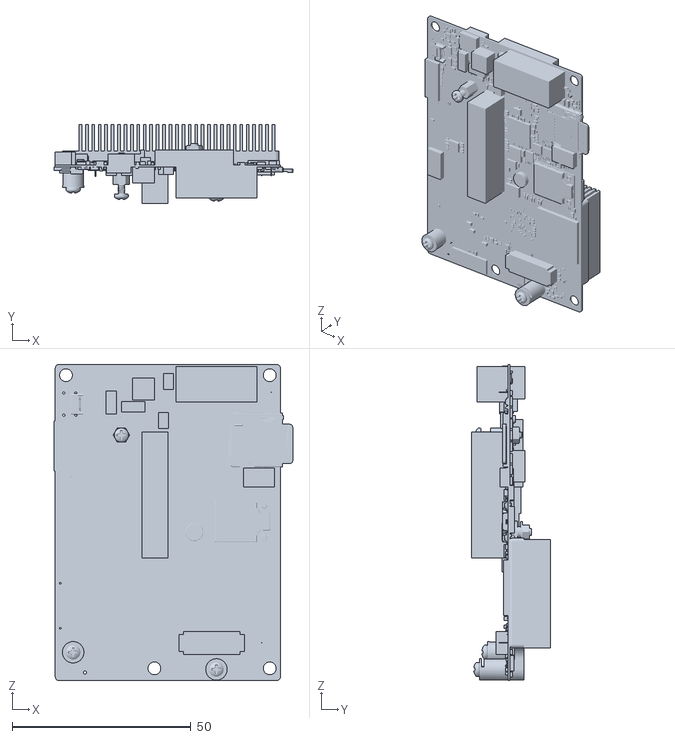
[picture p77: CAD file, 2017-03-15]
mechanical_cad/compute-board/compute-board.stl
66.7 x 22.2 x 88.4
