intel-aero/Documents/mechanical_cad/leg-extensions/leg-extension-25mm.STL

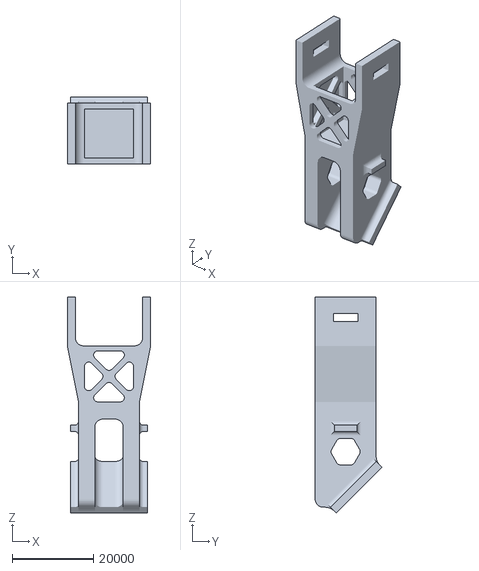
[picture p78: CAD file, 2017-06-27]
mechanical_cad/leg-extensions/leg-extension-25mm.STL
20500.0 x 16414.2 x 53063.7
