intel-aero/Documents/mechanical_cad/propeller-guard/propeller-guard-ring.STL

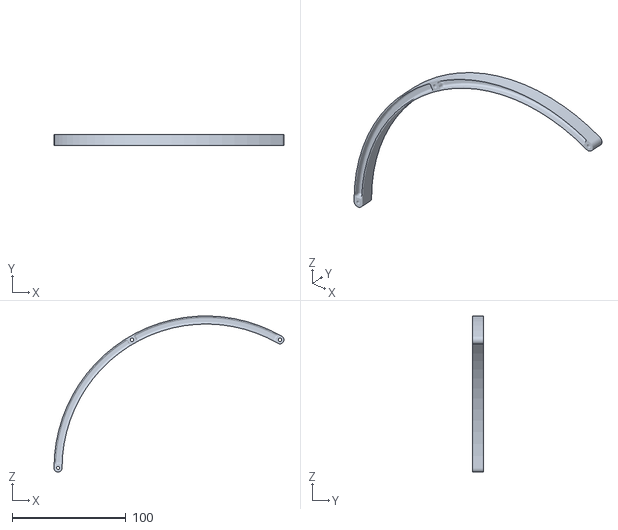
[picture p79: CAD file, 2017-06-22]
mechanical_cad/propeller-guard/propeller-guard-ring.STL
202.1 x 10.0 x 137.1
