intel-aero/Documents/mechanical_cad/px4flow-mount/px4flow-mount.STL

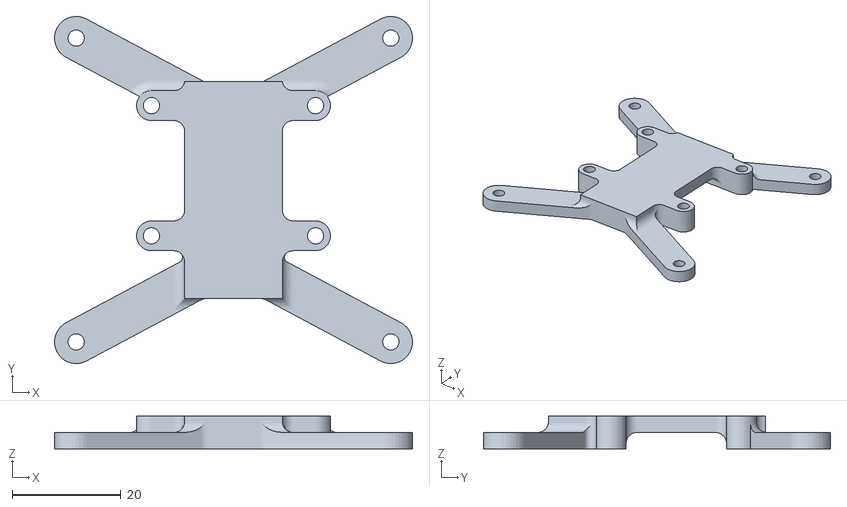
[picture p80: CAD file, 2017-07-07]
mechanical_cad/px4flow-mount/px4flow-mount.STL
66.0 x 64.0 x 6.00
