intel-aero/Documents/mechanical_cad/rtf-frame/custom/cgo3-gimbal-mount/battery-extension.stl

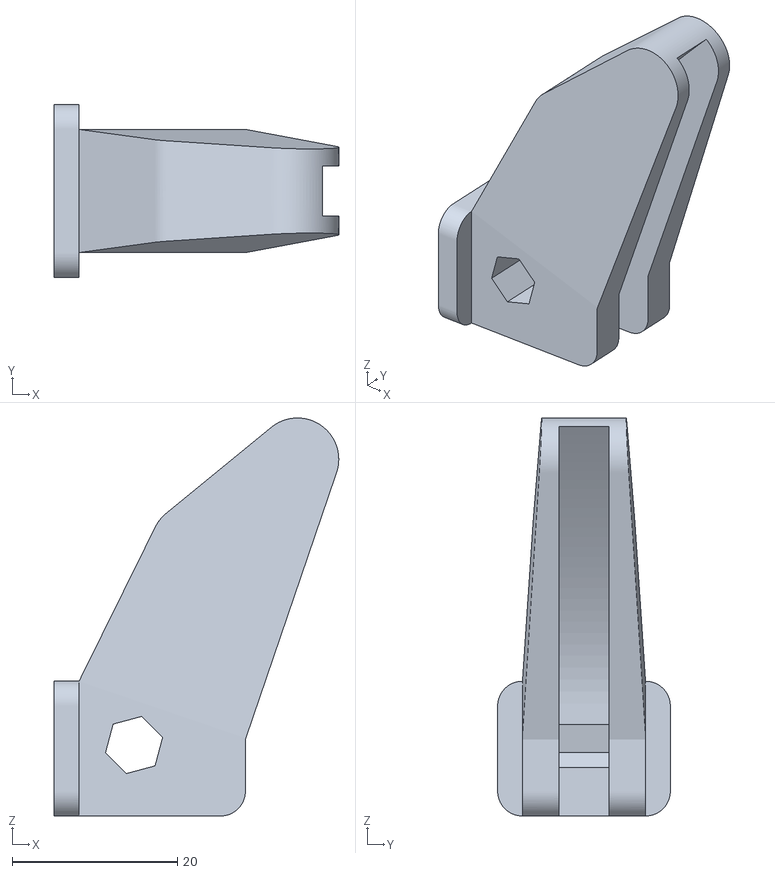
[picture p81: CAD file, 2017-05-13]
mechanical_cad/rtf-frame/custom/cgo3-gimbal-mount/battery-extension.stl
34.4 x 20.9 x 48.2
