intel-aero/Documents/mechanical_cad/rtf-frame/custom/downward-realsense-mount/downward-realsense-mount.stl

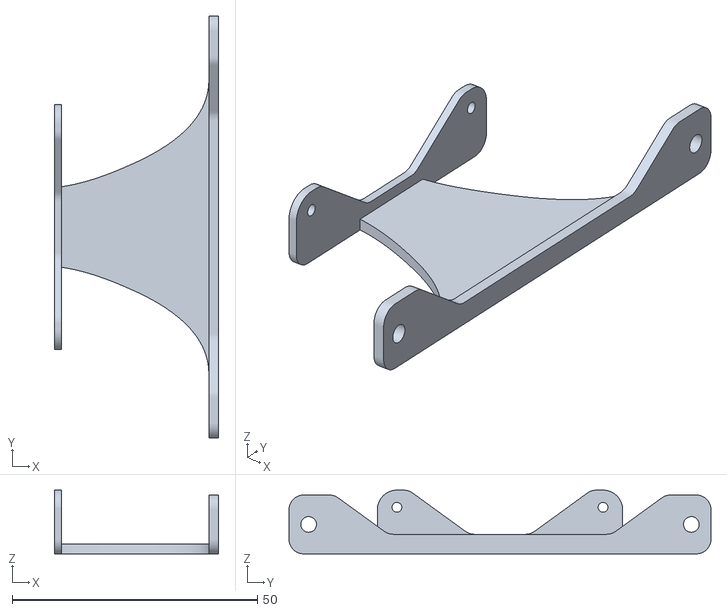
[picture p82: CAD file, 2017-05-13]
mechanical_cad/rtf-frame/custom/downward-realsense-mount/downward-realsense-mount.stl
33.5 x 86.0 x 13.0
