intel-aero/Documents/mechanical_cad/leg-extensions/leg-extension-109mm.STL

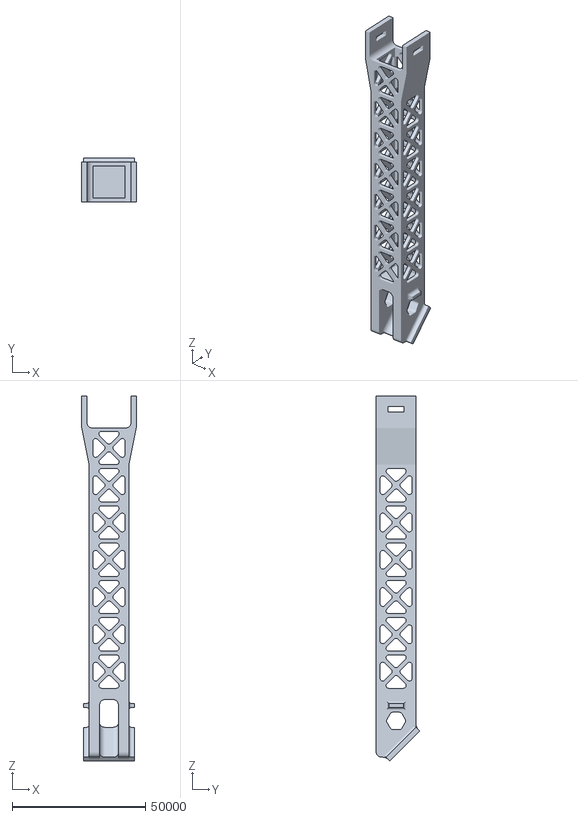
[picture p84: CAD file, 2017-06-27]
mechanical_cad/leg-extensions/leg-extension-109mm.STL
20500.0 x 16414.2 x 137063.7
