intel-aero/Documents/mechanical_cad/propeller-guard/propeller-guard-base.STL

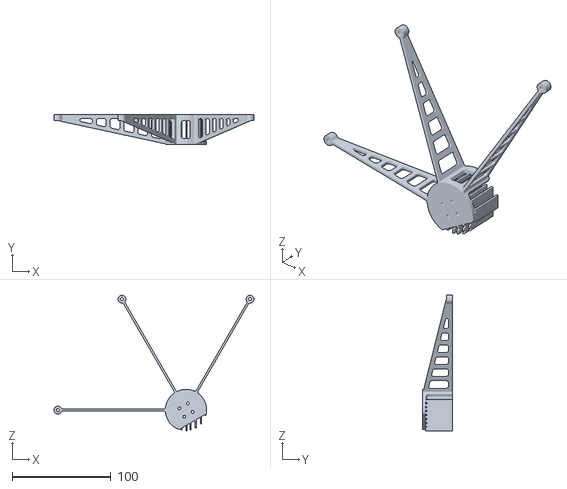
[picture p85: CAD file, 2017-06-16]
mechanical_cad/propeller-guard/propeller-guard-base.STL
203.0 x 30.0 x 137.6
