intel-aero/Documents/mechanical_cad/rtf-frame/custom/cgo3-gimbal-mount/leg-extension.stl

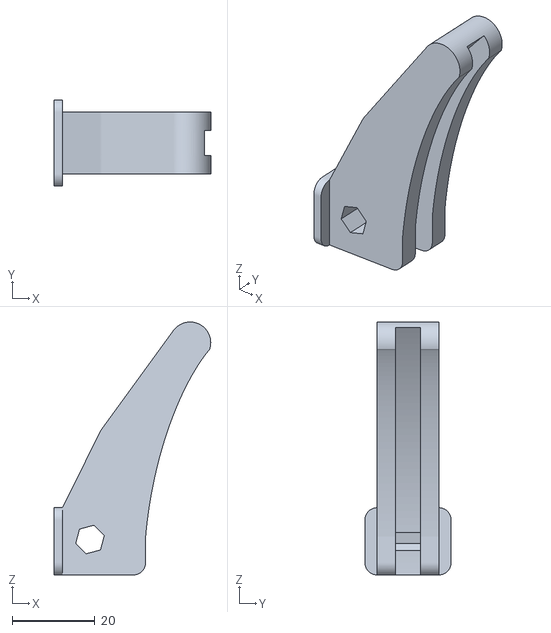
[picture p86: CAD file, 2017-05-13]
mechanical_cad/rtf-frame/custom/cgo3-gimbal-mount/leg-extension.stl
37.9 x 20.9 x 61.3
