intel-aero/Documents/mechanical_cad/leg-extensions/leg-extension-53mm.STL

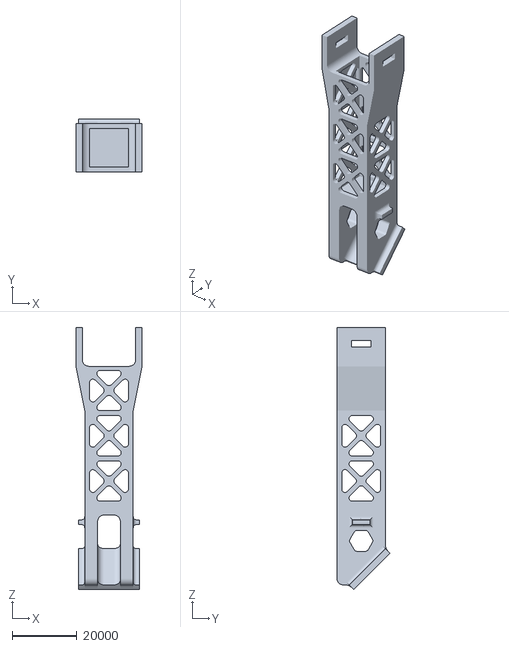
[picture p87: CAD file, 2017-06-27]
mechanical_cad/leg-extensions/leg-extension-53mm.STL
20500.0 x 16414.2 x 81063.7
