intel-aero/Documents/mechanical_cad/leg-extensions/leg-extension-67mm.STL

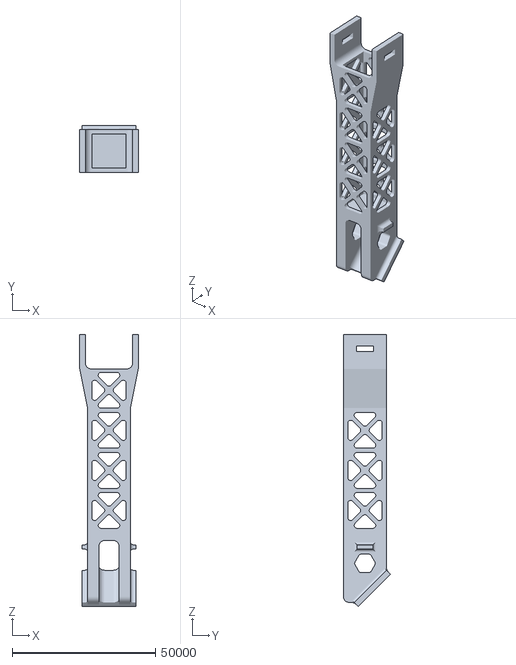
[picture p88: CAD file, 2017-06-27]
mechanical_cad/leg-extensions/leg-extension-67mm.STL
20500.0 x 16414.2 x 95063.7
