intel-aero/Documents/mechanical_cad/leg-extensions/leg-extension-81mm.STL

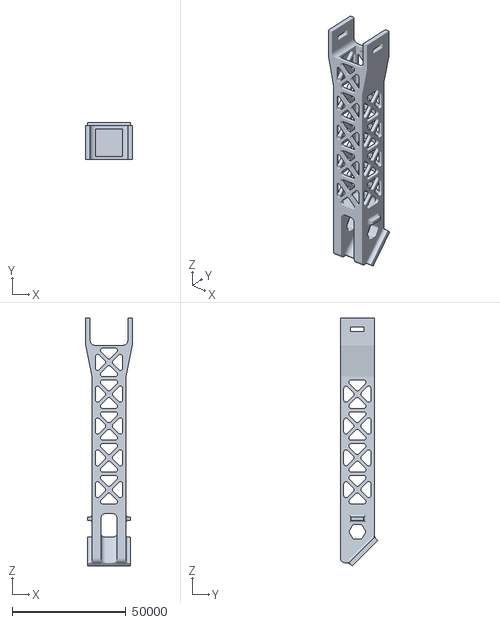
[picture p89: CAD file, 2017-06-27]
mechanical_cad/leg-extensions/leg-extension-81mm.STL
20500.0 x 16414.2 x 109063.7
