intel-aero/Documents/mechanical_cad/leg-extensions/leg-extension-123mm.STL

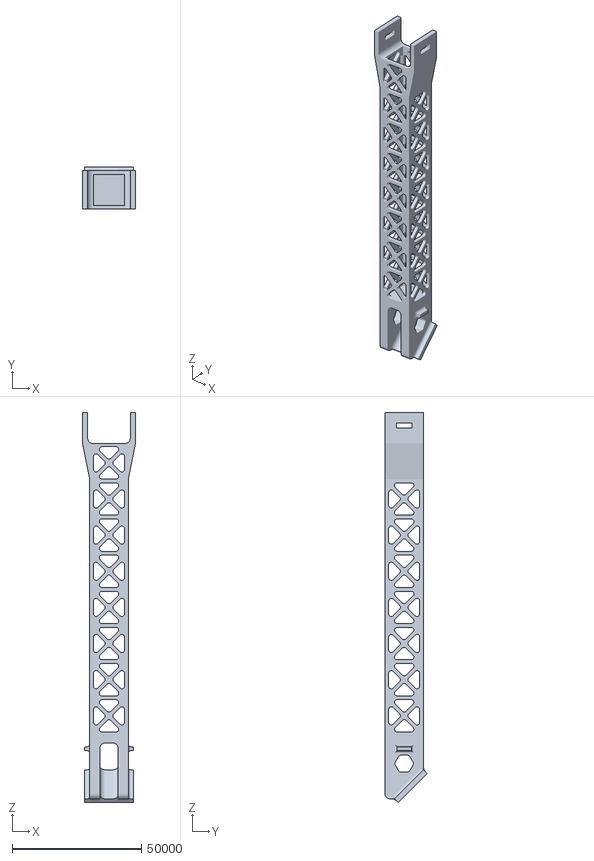
[picture p90: CAD file, 2017-06-27]
mechanical_cad/leg-extensions/leg-extension-123mm.STL
20500.0 x 16414.2 x 151063.7
