intel-aero/Documents/mechanical_cad/leg-extensions/leg-extension-95mm.STL

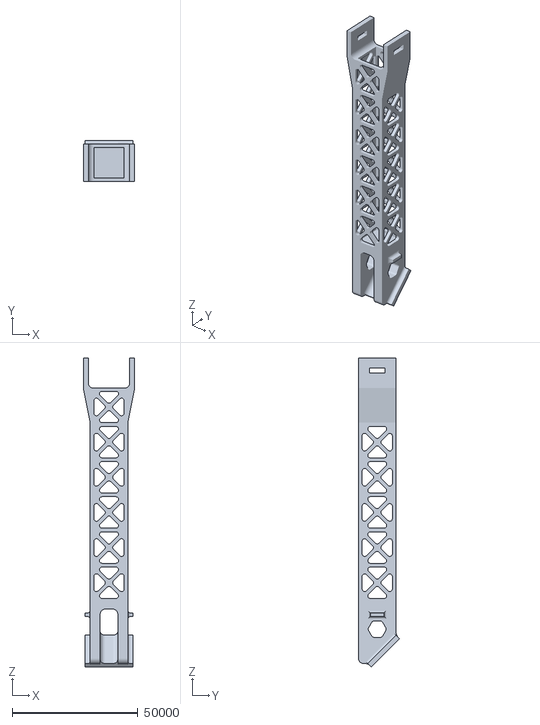
[picture p91: CAD file, 2017-06-27]
mechanical_cad/leg-extensions/leg-extension-95mm.STL
20500.0 x 16414.2 x 123063.7
