intel-aero/Documents/mechanical_cad/leg-extensions/leg-extension-39mm.STL

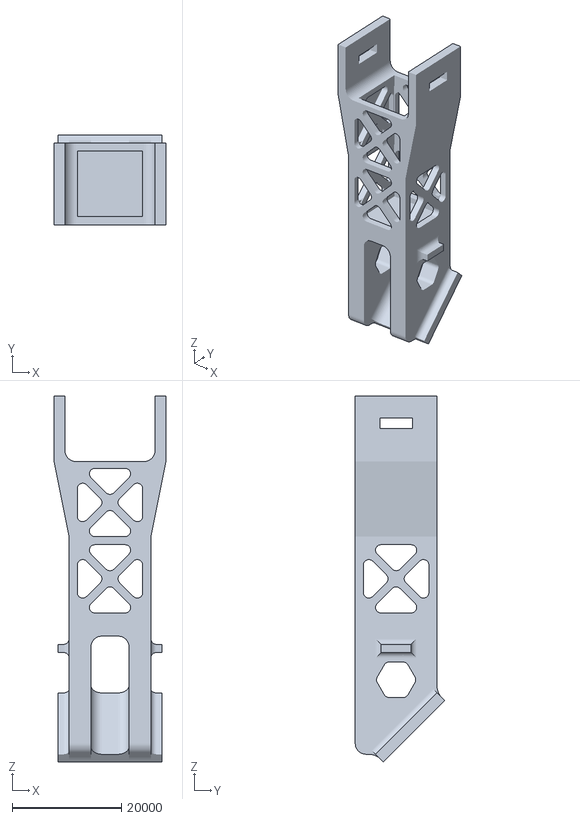
[picture p92: CAD file, 2017-06-27]
mechanical_cad/leg-extensions/leg-extension-39mm.STL
20500.0 x 16414.2 x 67063.7
