intel-aero/Documents/doc_photos/guide_1.png

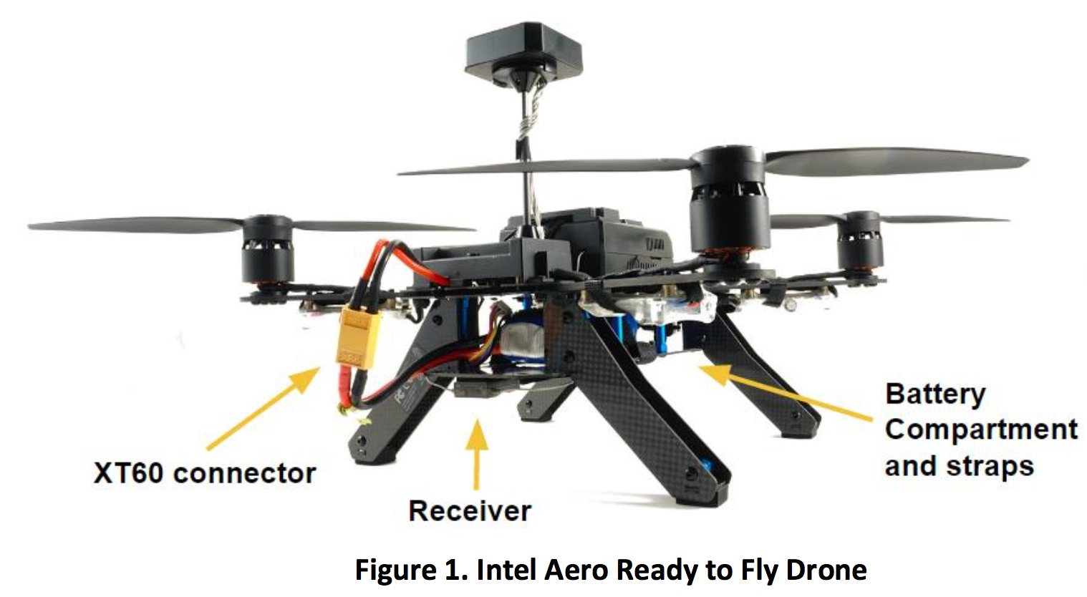
doc_photos/guide_1.png
