intel-aero/Documents/doc_photos/guide_2.png

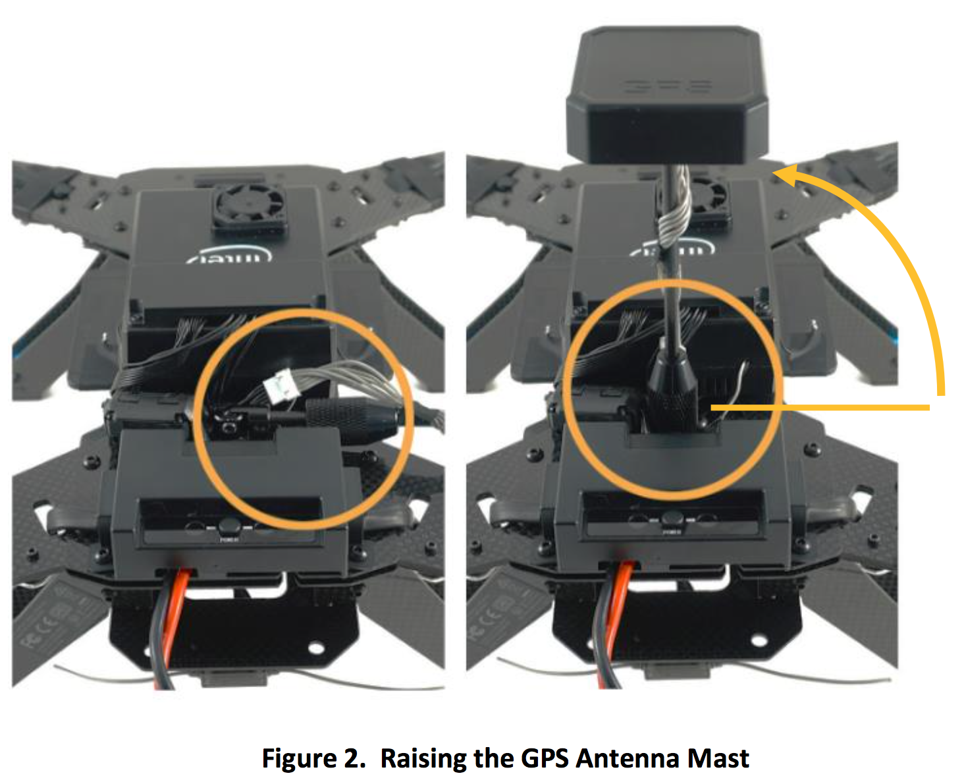
doc_photos/guide_2.png
