intel-aero/Documents/doc_photos/guide_3.png

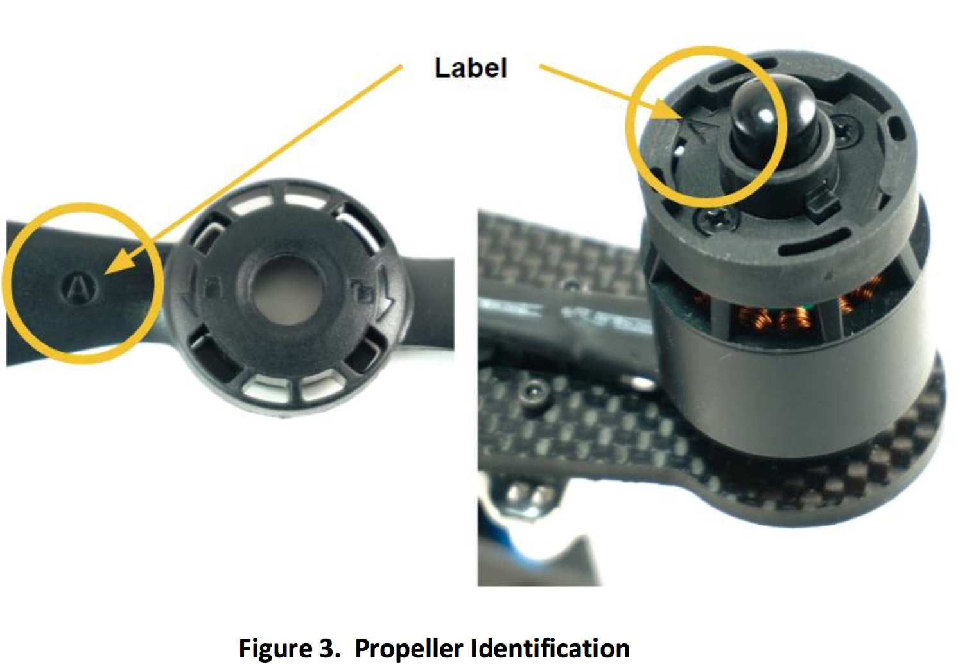
doc_photos/guide_3.png
