intel-aero/Documents/doc_photos/guide_4.png

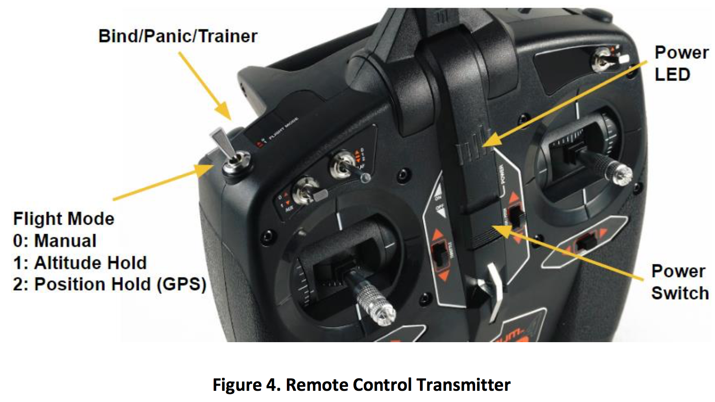
doc_photos/guide_4.png
