intel-aero/Documents/doc_photos/guide_5.png

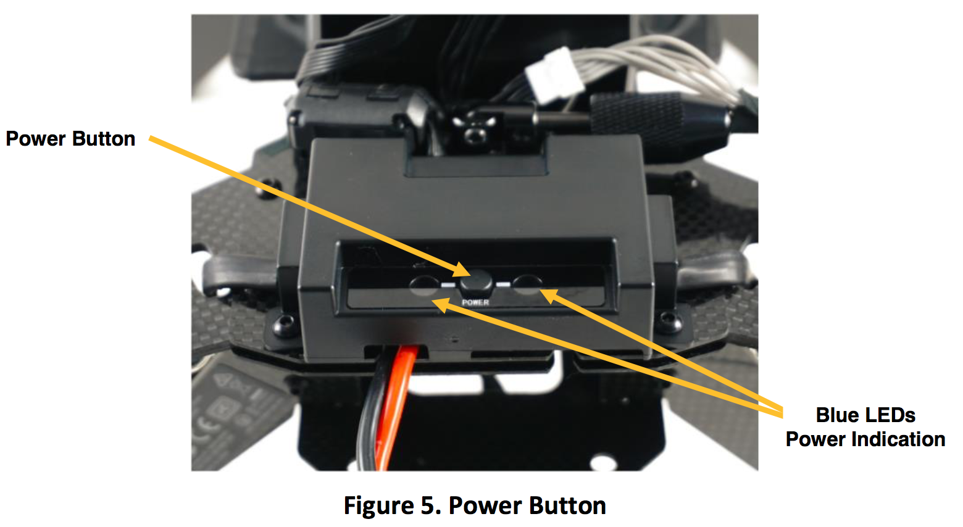
doc_photos/guide_5.png
