intel-aero/Documents/doc_photos/guide_6.png

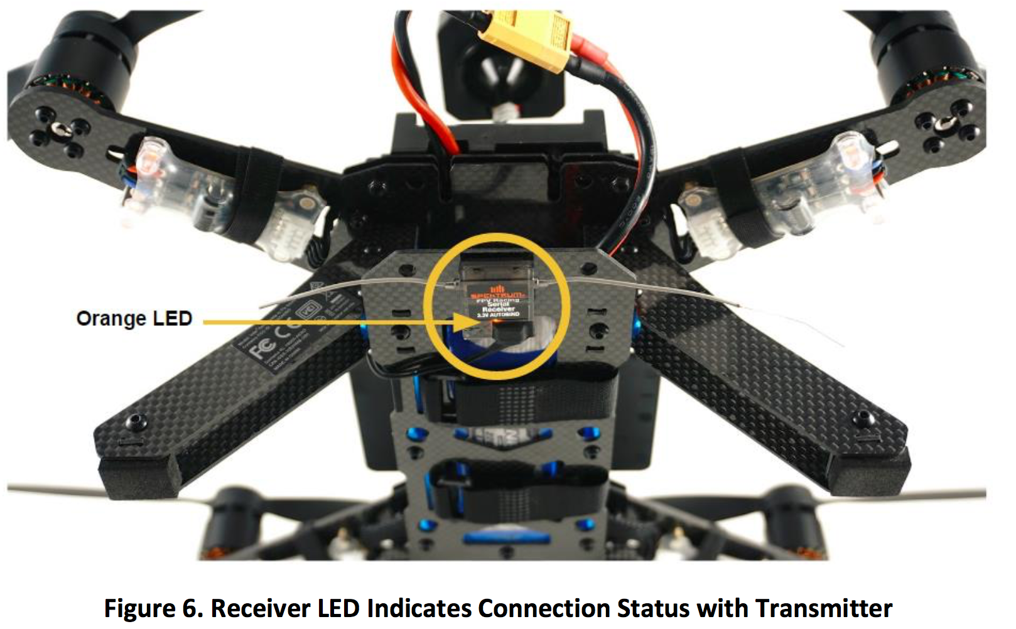
doc_photos/guide_6.png
