intel-aero/Documents/doc_photos/guide_7.png

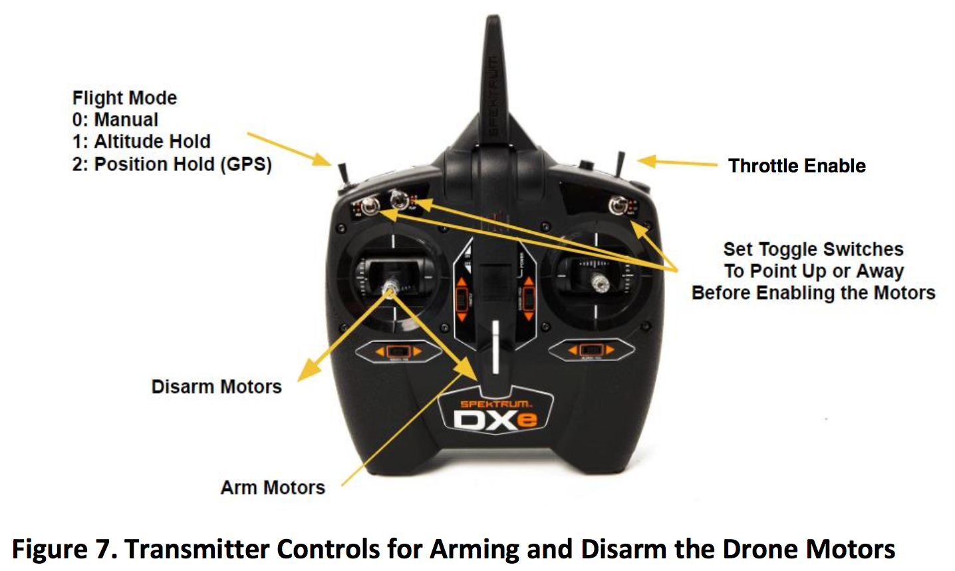
doc_photos/guide_7.png
