intel-aero/Documents/doc_photos/guide_8.png

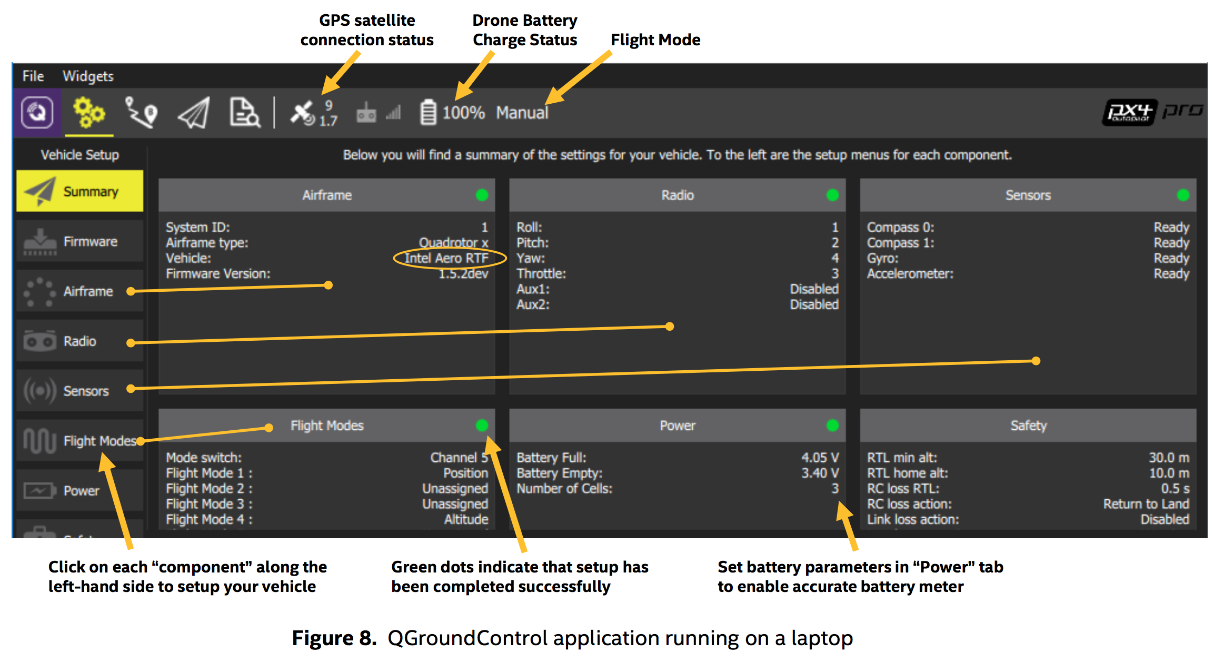
doc_photos/guide_8.png
