intel-aero/Documents/doc_photos/install_01_md5_windows.png

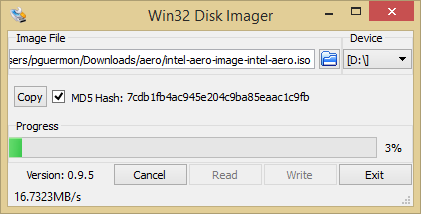
doc_photos/install_01_md5_windows.png
