intel-aero/Documents/doc_photos/install_02_flash_linux.png

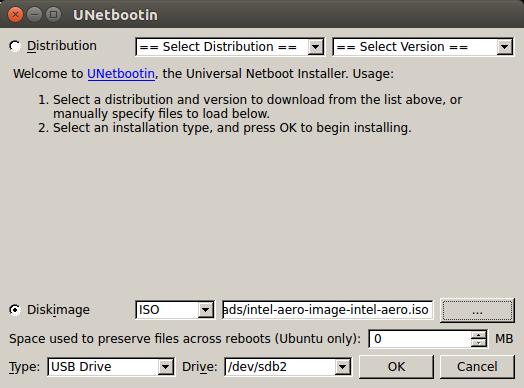
doc_photos/install_02_flash_linux.png
