intel-aero/Documents/doc_photos/install_02_flash_windows_filter.png

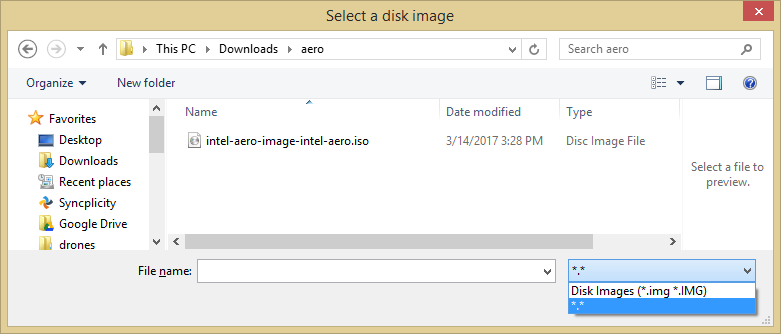
doc_photos/install_02_flash_windows_filter.png
