intel-aero/Documents/doc_photos/install_bios_bootmanager.jpg

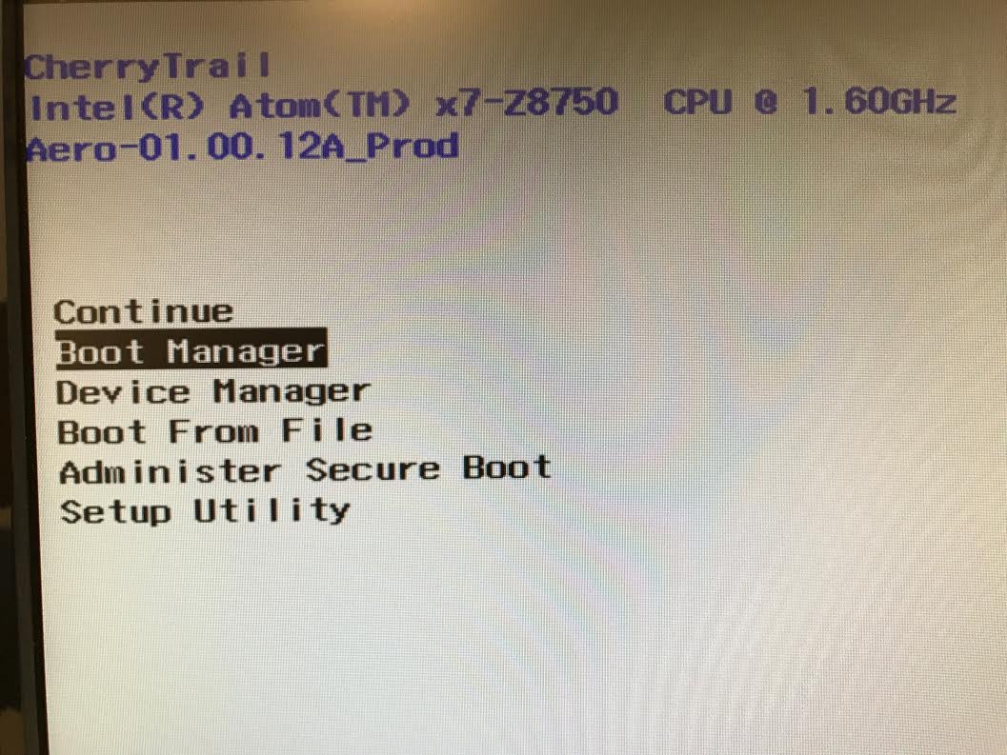
doc_photos/install_bios_bootmanager.jpg
