intel-aero/Documents/doc_photos/install_bios_update.jpg

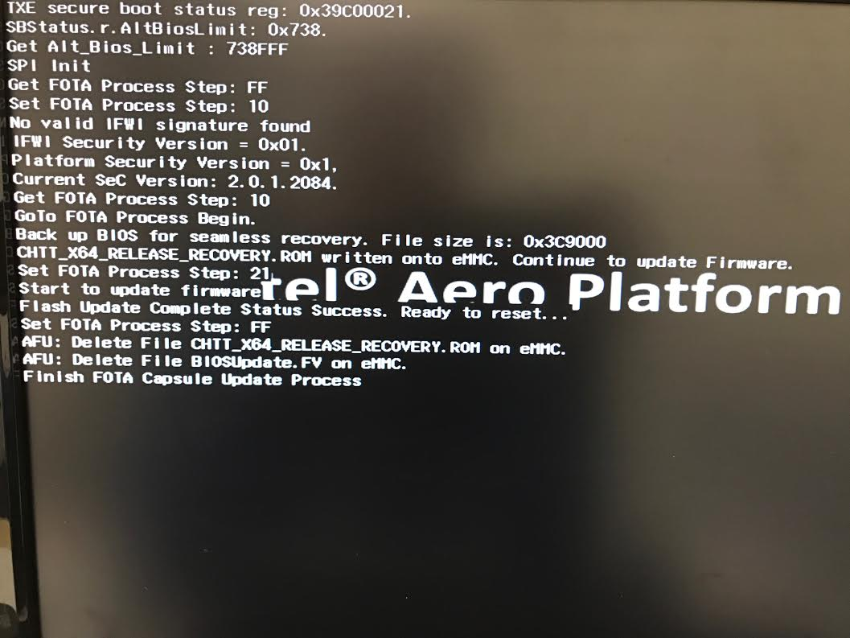
doc_photos/install_bios_update.jpg
