intel-aero/Documents/doc_photos/install_bios_usb.jpg

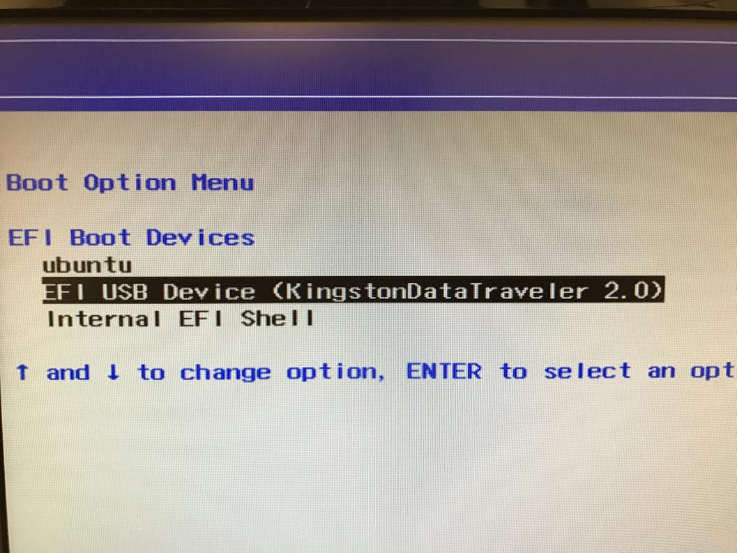
doc_photos/install_bios_usb.jpg
