intel-aero/Documents/doc_photos/install_yocto_end.jpg

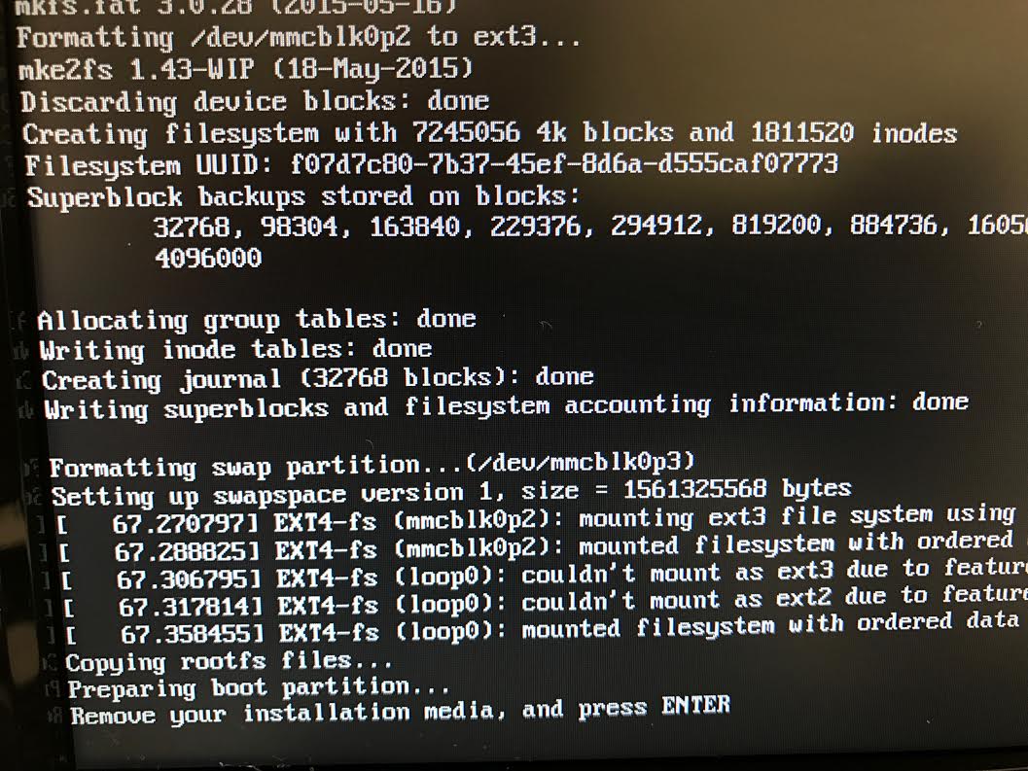
doc_photos/install_yocto_end.jpg
