intel-aero/Documents/doc_photos/install_yocto_grub.jpg

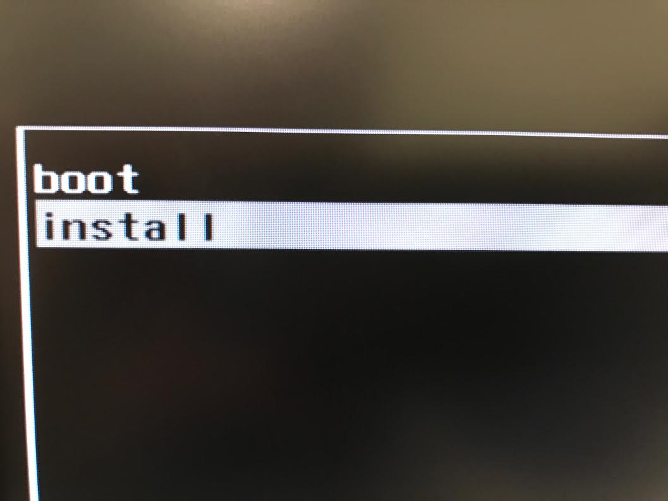
doc_photos/install_yocto_grub.jpg
