intel-aero/Documents/doc_photos/install_yocto_question.jpg

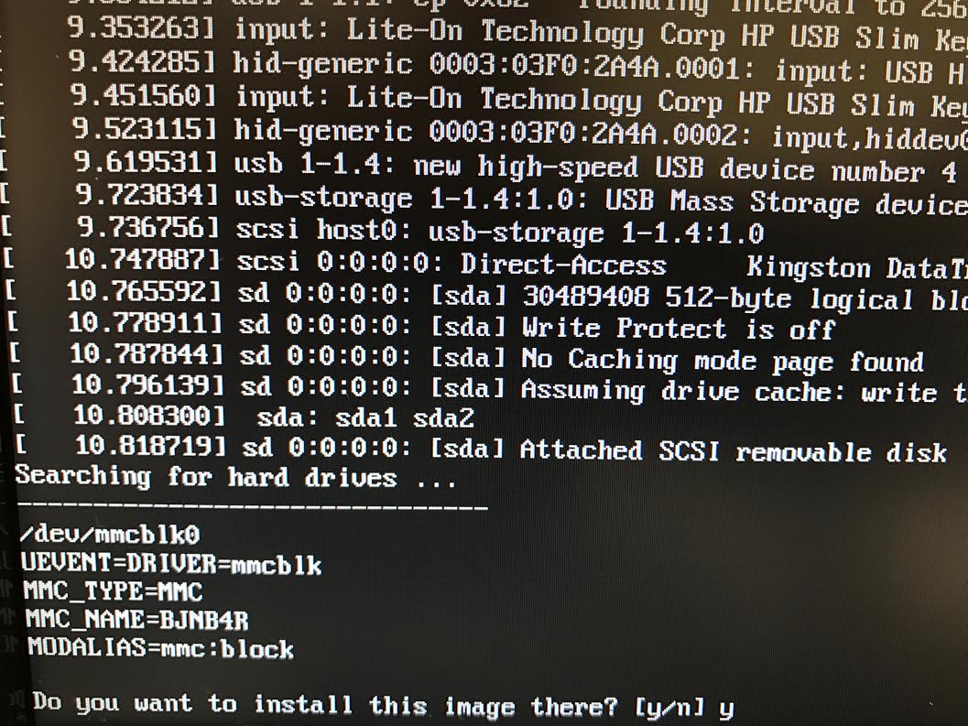
doc_photos/install_yocto_question.jpg
