intel-aero/Documents/doc_photos/install_yocto_terminal.jpg

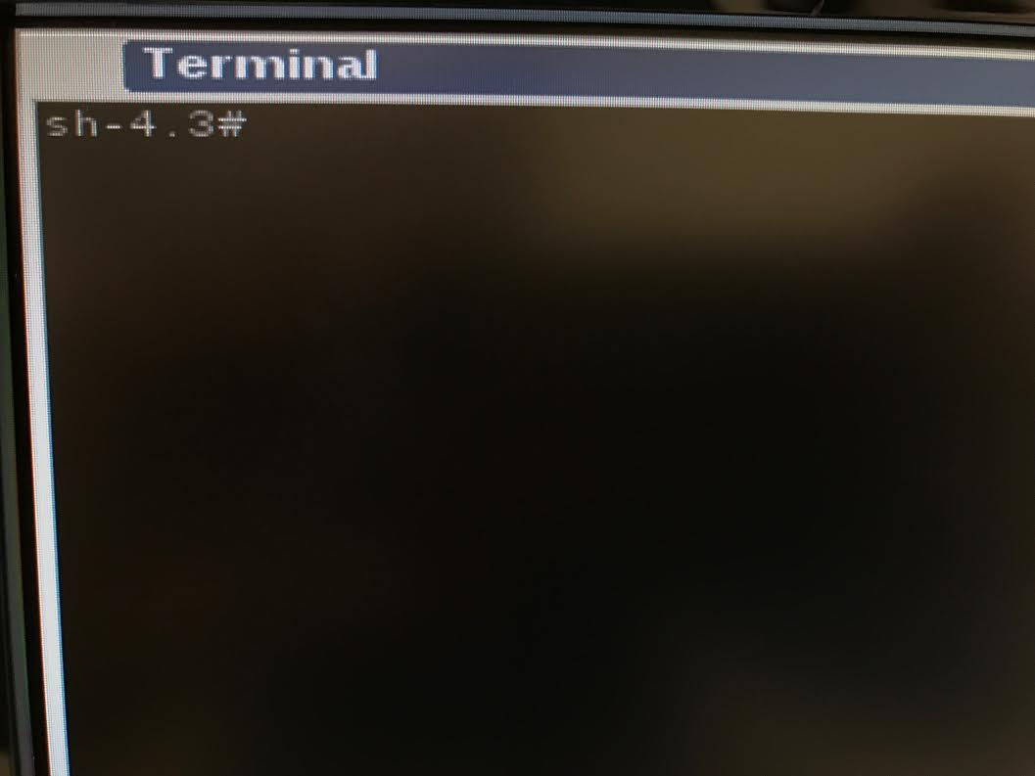
doc_photos/install_yocto_terminal.jpg
