intel-aero/Documents/doc_photos/pixhawk_aero_setup.jpg

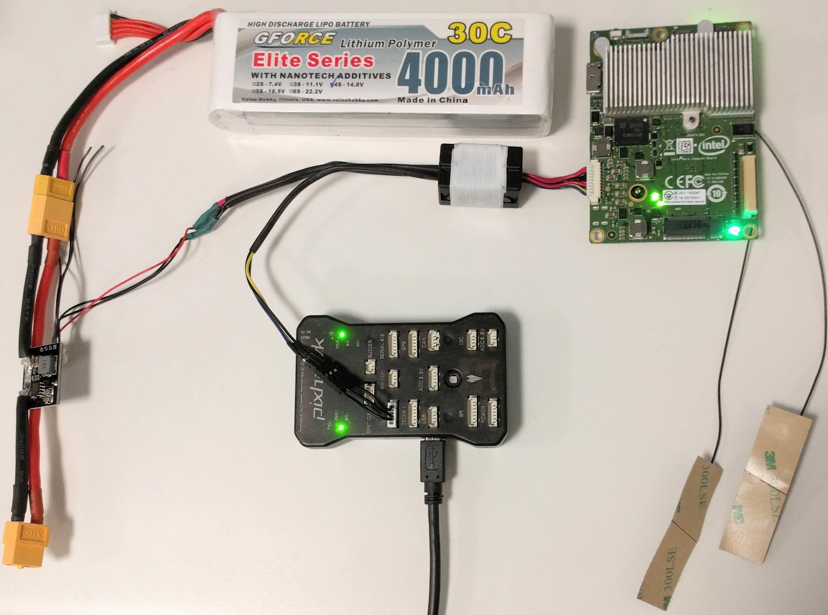
doc_photos/pixhawk_aero_setup.jpg
