intel-aero/Documents/mechanical_cad/enclosure-kit/enclosure-kit-assembly.png

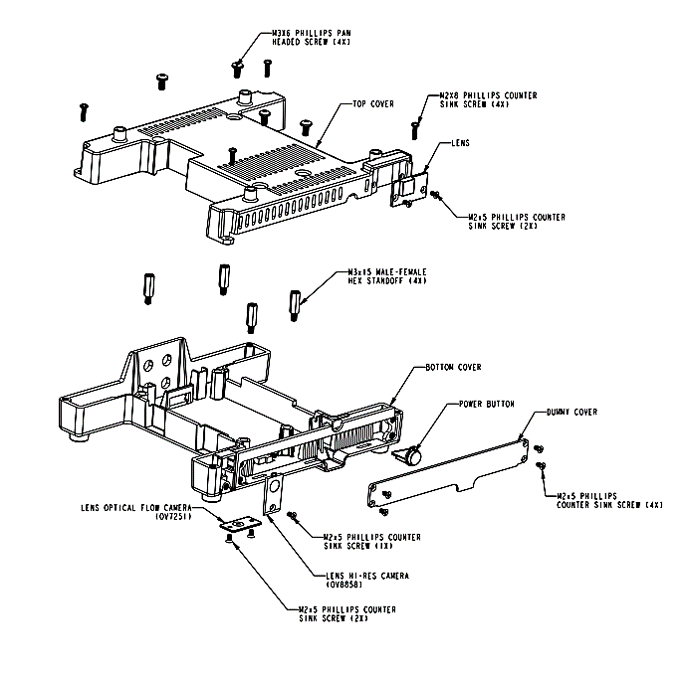
mechanical_cad/enclosure-kit/enclosure-kit-assembly.png
