intel-aero/Documents/doc_photos/barcode_test.png

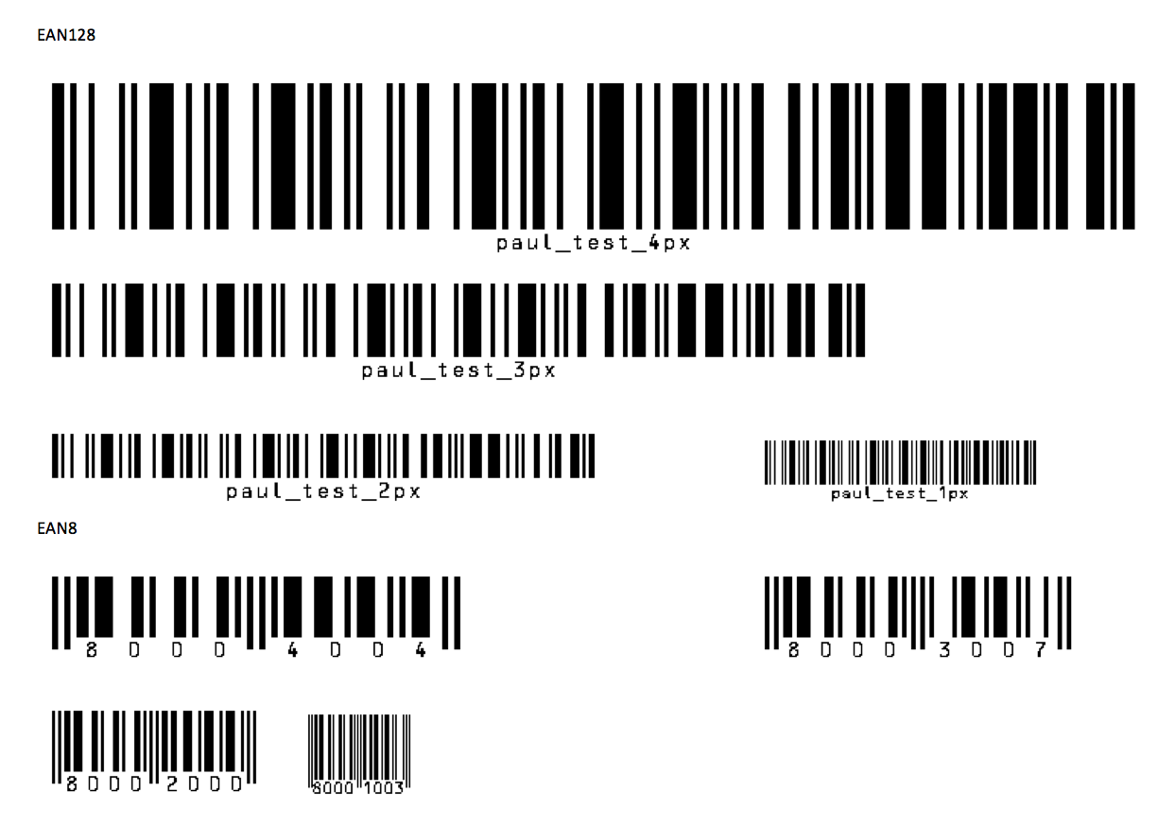
doc_photos/barcode_test.png
