intel-aero/Documents/doc_photos/calibration_01.png

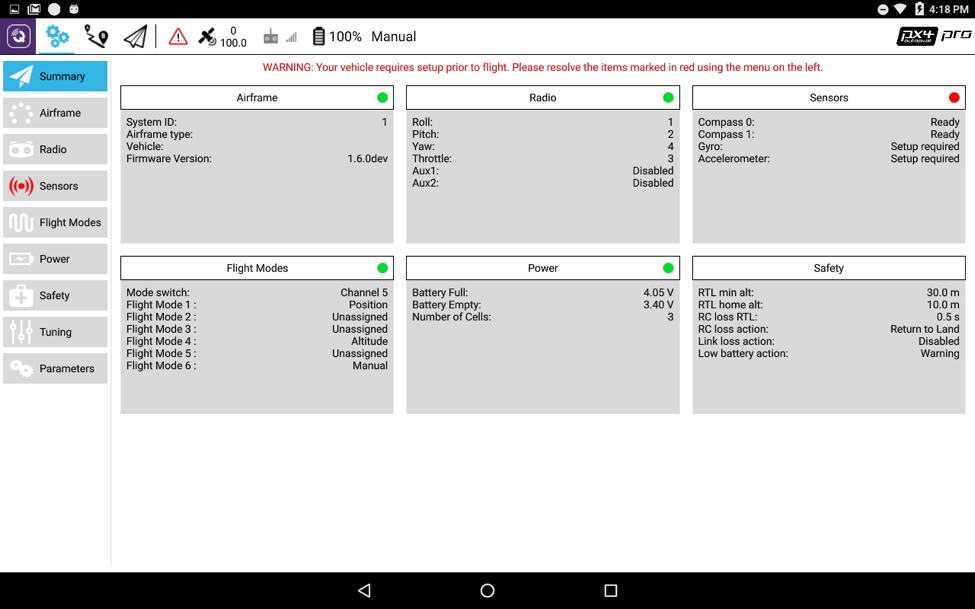
doc_photos/calibration_01.png
