intel-aero/Documents/doc_photos/calibration_02.png

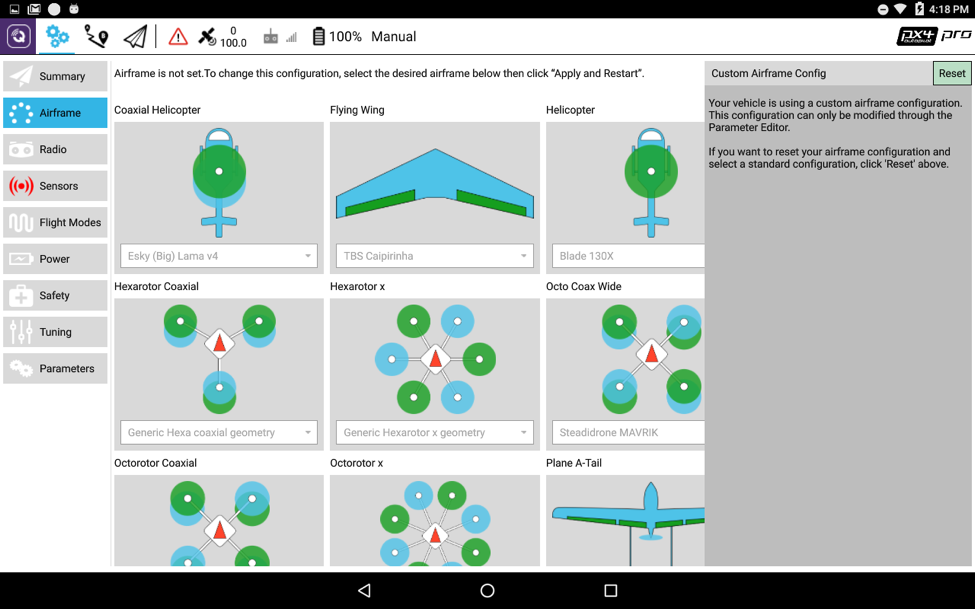
doc_photos/calibration_02.png
