intel-aero/Documents/doc_photos/calibration_03.png

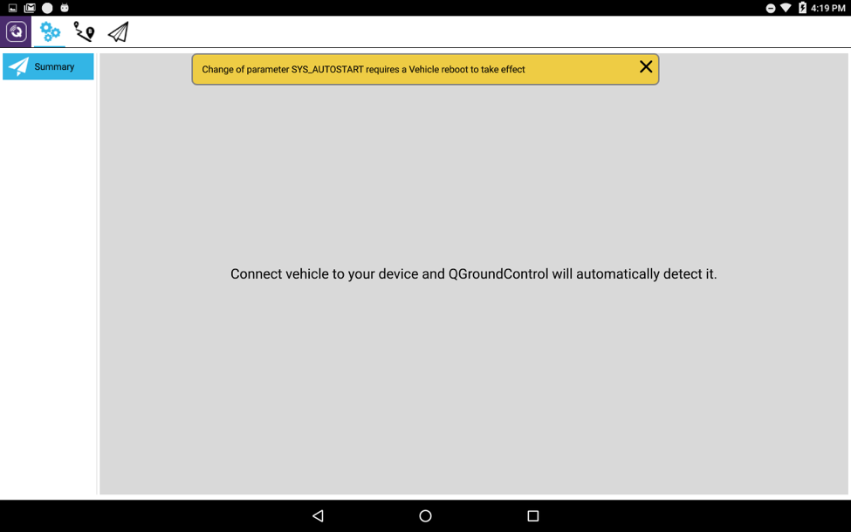
doc_photos/calibration_03.png
