intel-aero/Documents/doc_photos/calibration_04.png

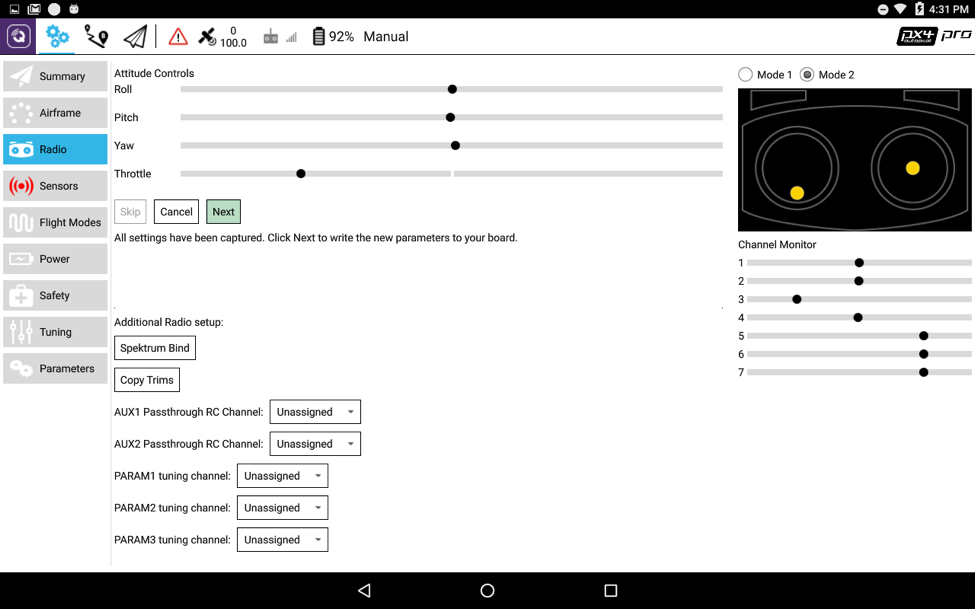
doc_photos/calibration_04.png
