intel-aero/Documents/doc_photos/calibration_05.png

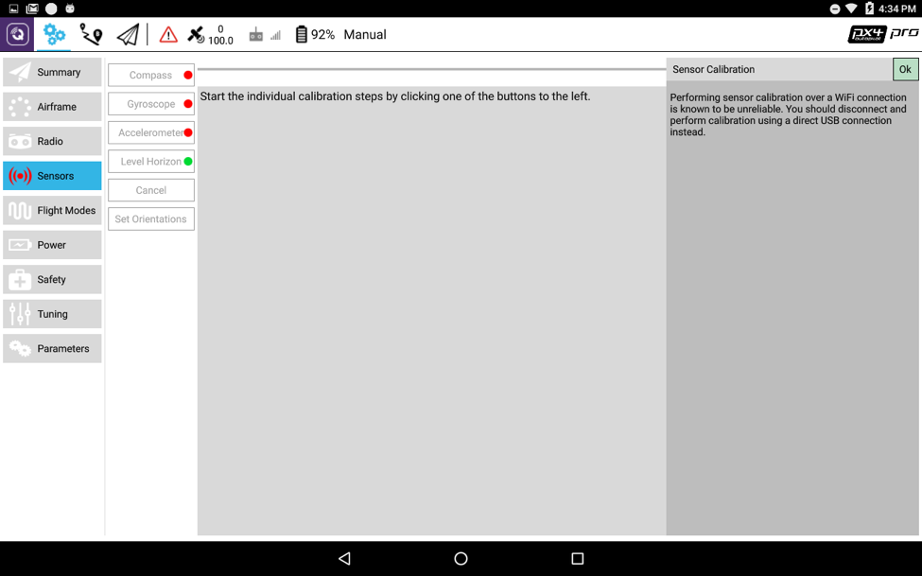
doc_photos/calibration_05.png
