intel-aero/Documents/doc_photos/calibration_07.png

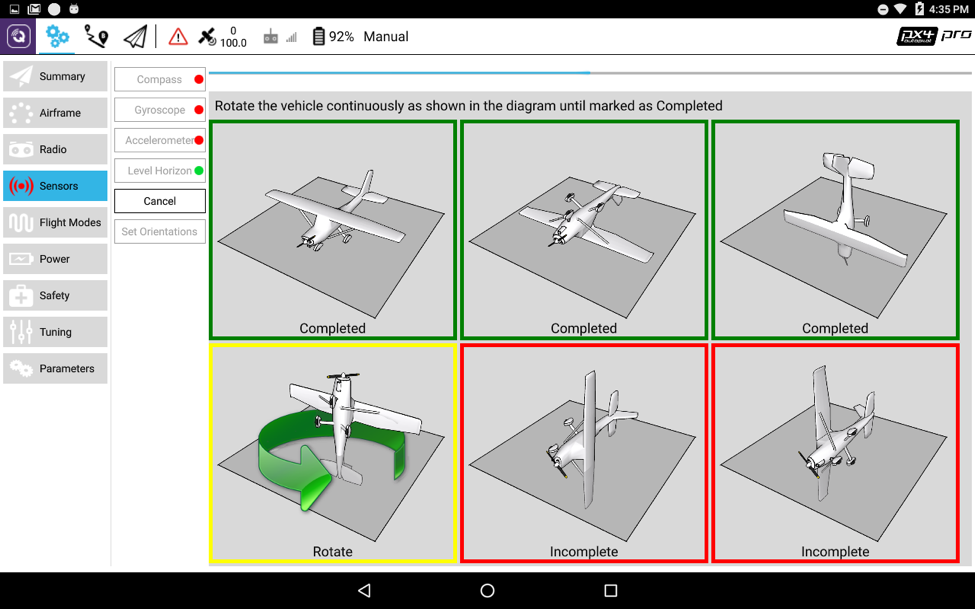
doc_photos/calibration_07.png
