intel-aero/Documents/doc_photos/calibration_08.png

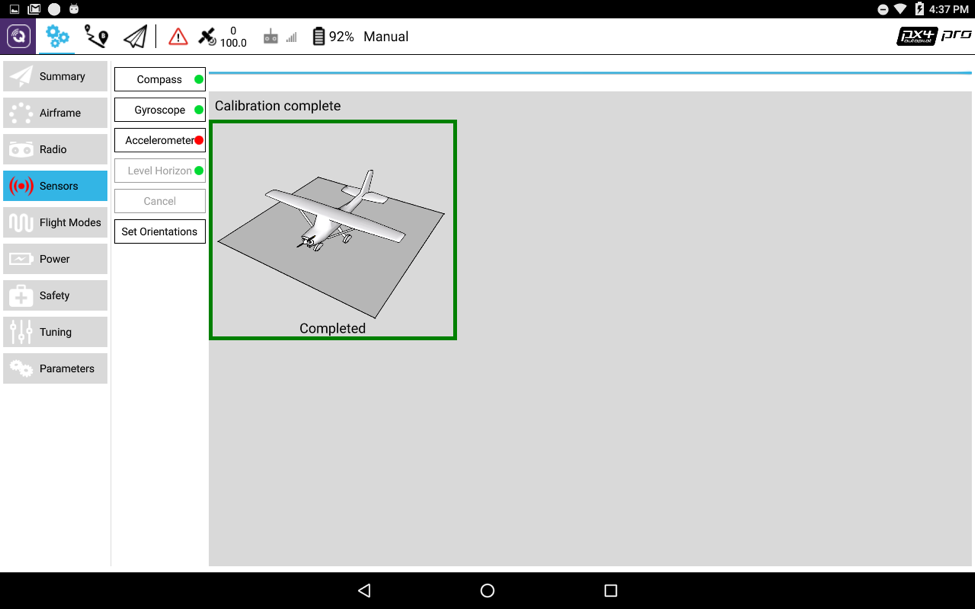
doc_photos/calibration_08.png
