intel-aero/Documents/doc_photos/calibration_09.png

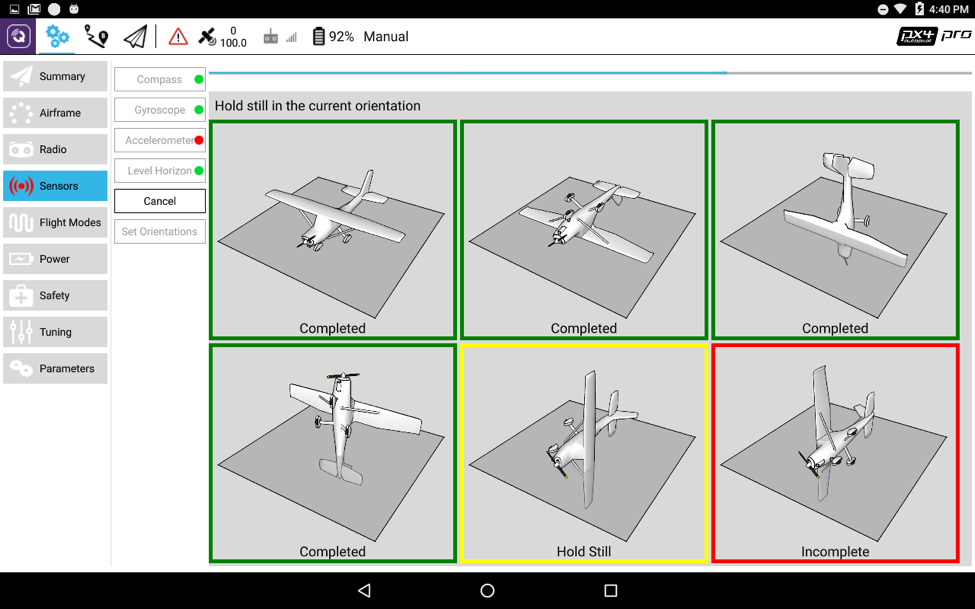
doc_photos/calibration_09.png
