intel-aero/Documents/doc_photos/calibration_11.png

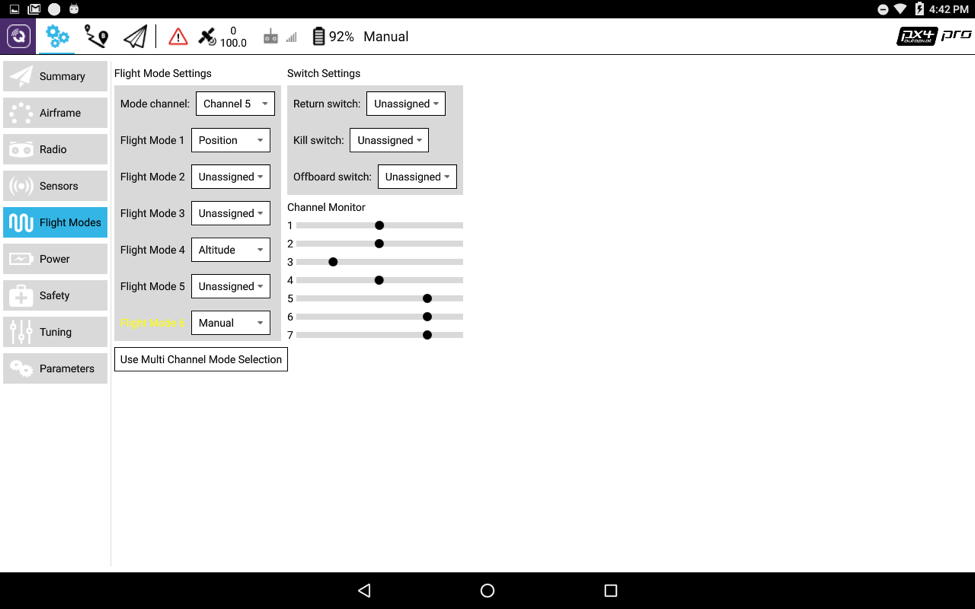
doc_photos/calibration_11.png
