intel-aero/Documents/(threads)

Thread 1 (2017-06-16):

default enclosure kit stl/stp files missing

jegb, 2017-06-16:
I could not find the cad files for [the default casing ](http://us.yuneec.com/Aero-Drone-Enclosure-box-for-Flight-Controller)
Is the commit containing incorrect description or is only the larger casing kit cad data available?

Thread 3 (2018-11-28):

One part of the Intel Aero UAV is broken.

Kumaron, 2018-11-28:
As is shown in https://communities.intel.com/servlet/JiveServlet/downloadImage/2-594832-534177/1440-1080/uav1.jpg, one part of Intel Aero RTF is broken. Can you provide a stl file or other type of file of this part so that I can repair the uav by 3D-print?
Thanks in advance.
