intel-aero/Documents/(commit log)

2017-03-15 Adding STP/STL for Aero Compute Board and Enclosure Kit.
    [compute-board.stl]
2017-03-15 Add dimension and assembly illustrations
2017-04-14 RGB LED on RTF
2017-04-17 Added RTF frame STP file
    [rtf-frame.stp]
2017-04-19 Add STL for rtf-frame
2017-05-13 Added a few RTF frame customization CAD files
    [battery-extension.stl, downward-realsense-mount.stl, leg-extension.stl]
2017-06-16 Added propeller guard STLs
    [propeller-guard-base.STL, propeller-guard-ring.STL]
2017-06-22 Updated propeller guards
    [propeller-guard-base.STL, propeller-guard-ring.STL]
2017-06-27 Added leg extensions
    [leg_extension_109mm.STL, leg_extension_123mm.STL, leg_extension_25mm.STL, leg_extension_39mm.STL, leg_extension_53mm.STL, leg_extension_67mm.STL, leg_extension_81mm.STL, leg_extension_95mm.STL]
2017-06-29 Added CGO3+ gimbal mount
    [cgo3+-gimbal-mount.STL, leg-extension-109mm.STL, leg-extension-123mm.STL, leg-extension-25mm.STL, leg-extension-39mm.STL, leg-extension-53mm.STL, leg-extension-67mm.STL, leg-extension-81mm.STL]
2017-07-03 Added antenna mount
    [antenna-mount.STL]
2017-07-07 Added px4flow mount
    [px4flow-mount.STL]
